hotchk155/MIDI-Switcher/images/001.JPG

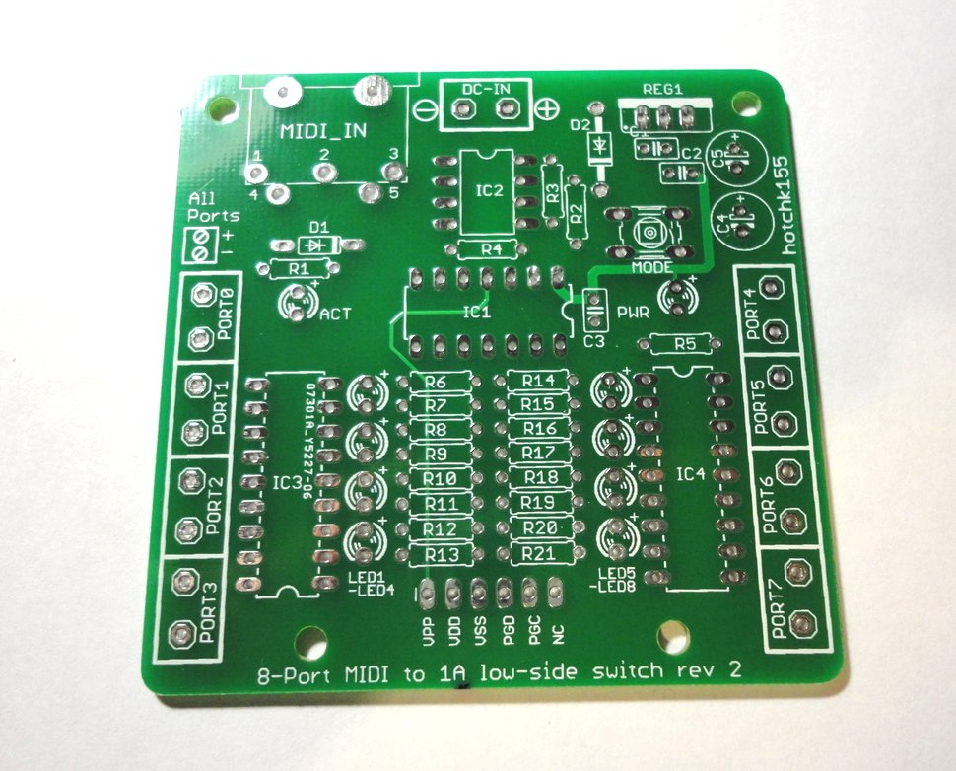
images/001.JPG
