hotchk155/MIDI-Switcher/images/018.JPG

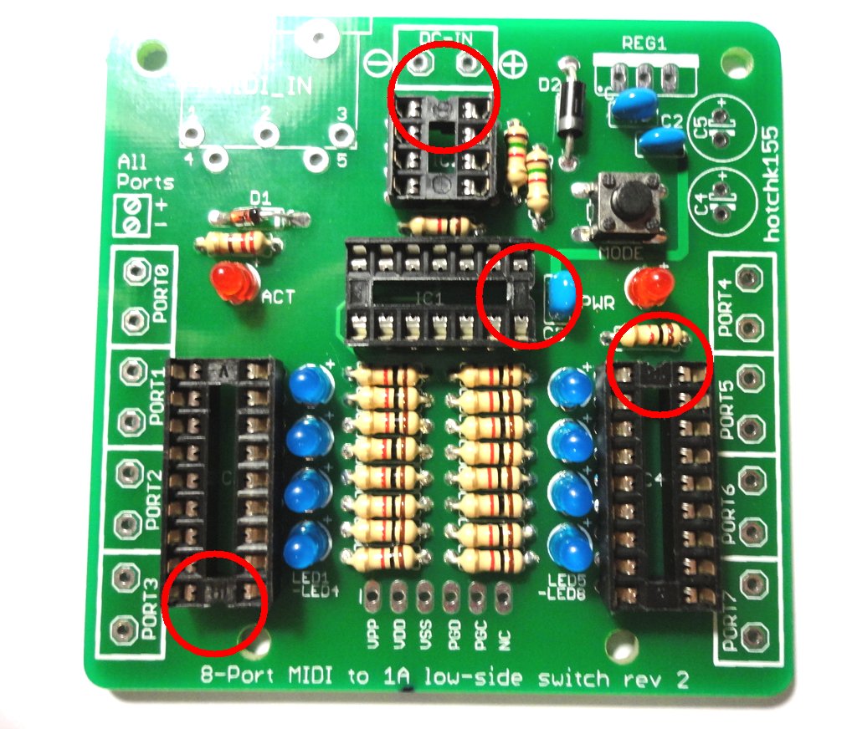
images/018.JPG
