hotchk155/MIDI-Switcher/README.md

The old project. Check MIDI-Switcher-2 for new one
