hotchk155/MIDI-Switcher/images/002.JPG

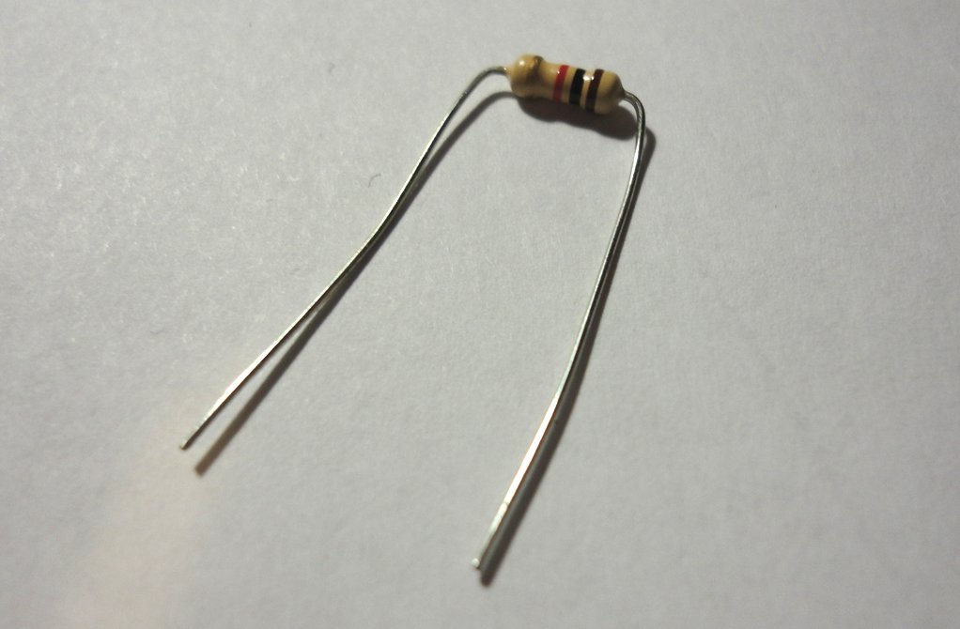
images/002.JPG
