hotchk155/MIDI-Switcher/images/003.JPG

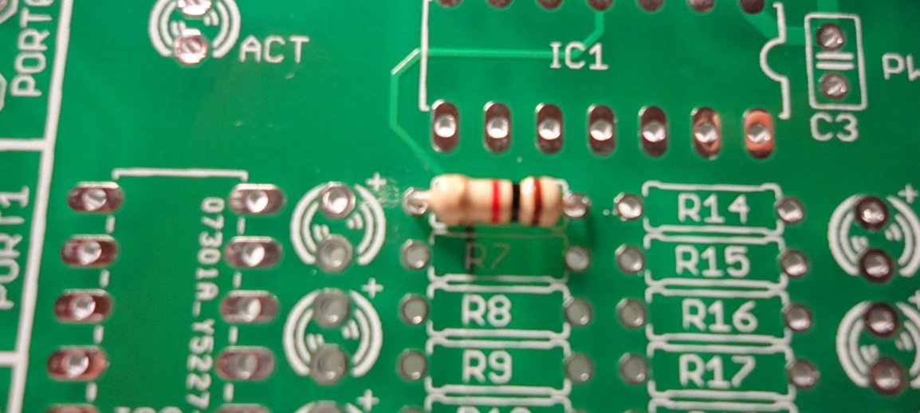
images/003.JPG
