hotchk155/MIDI-Switcher/images/004.JPG

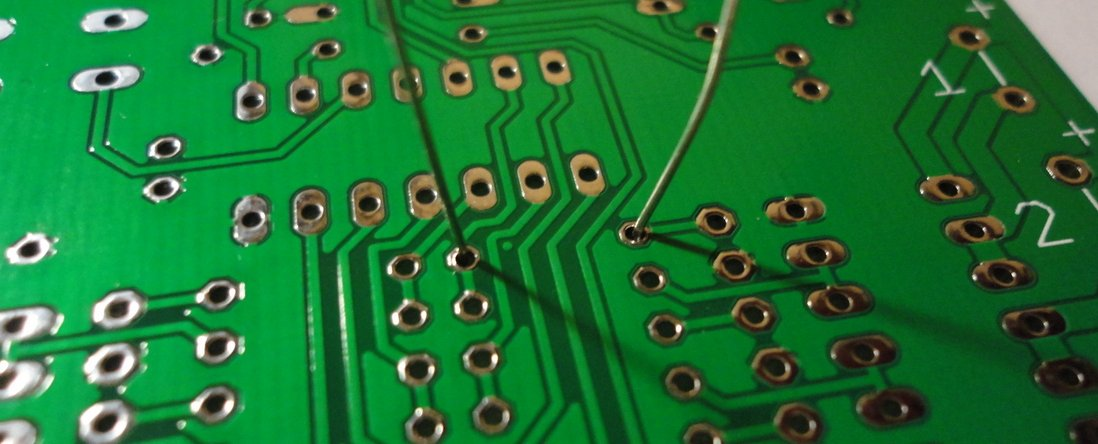
images/004.JPG
