hotchk155/MIDI-Switcher/images/005.JPG

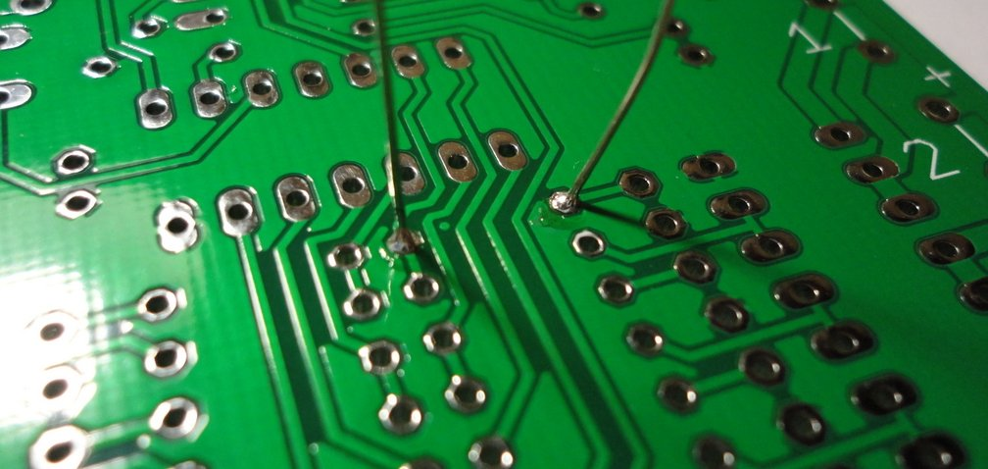
images/005.JPG
