hotchk155/MIDI-Switcher/images/006.JPG

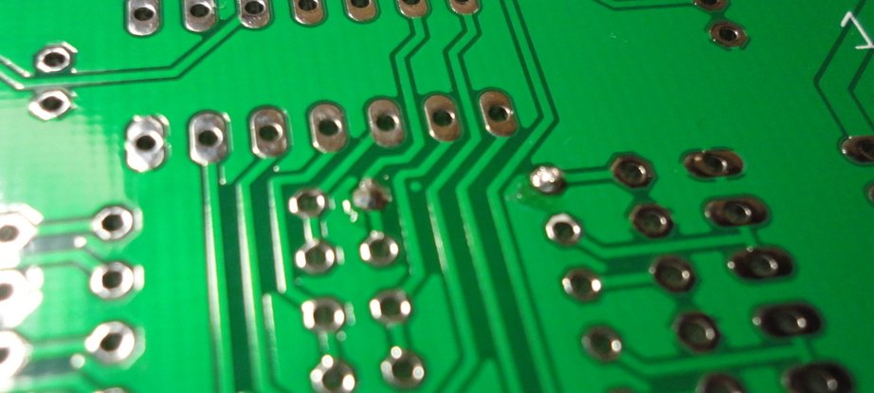
images/006.JPG
