hotchk155/MIDI-Switcher/images/007.JPG

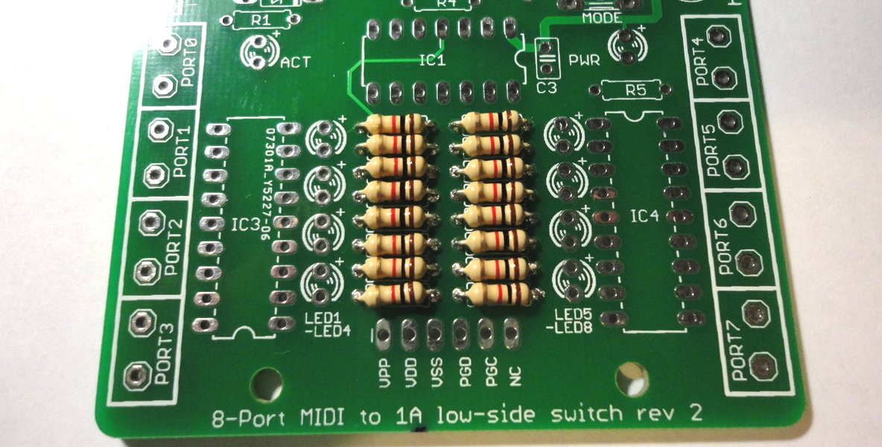
images/007.JPG
