hotchk155/MIDI-Switcher/images/008.JPG

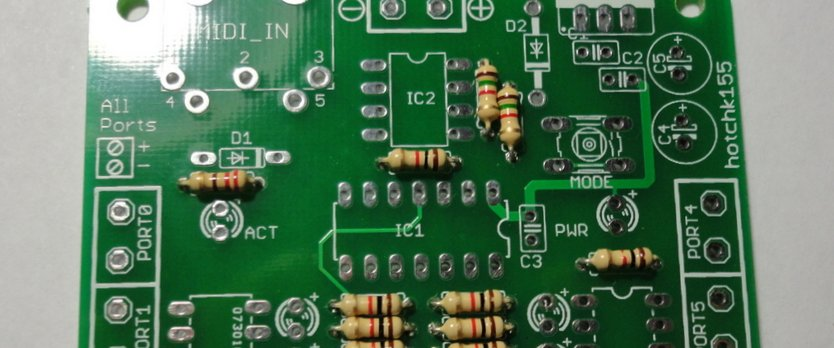
images/008.JPG
