hotchk155/MIDI-Switcher/images/009.JPG

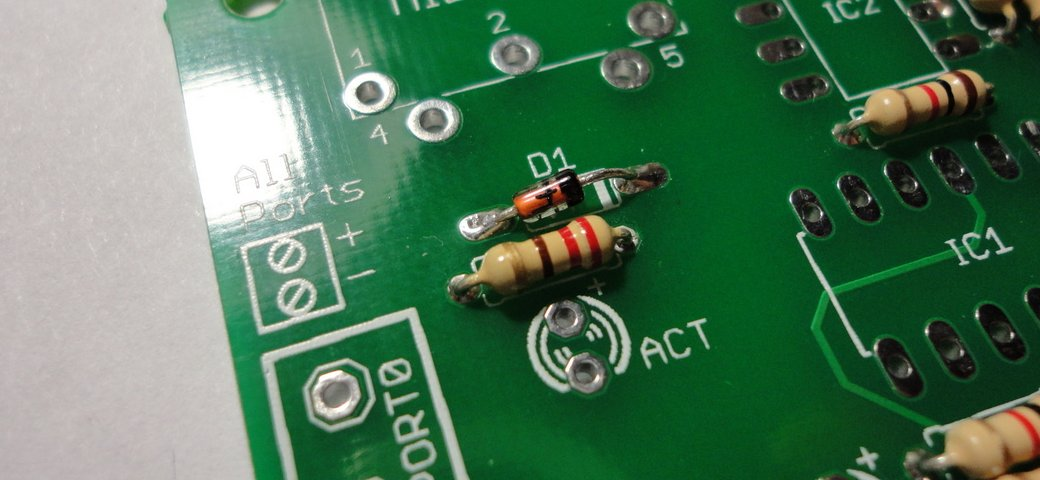
images/009.JPG
