hotchk155/MIDI-Switcher/images/010.JPG

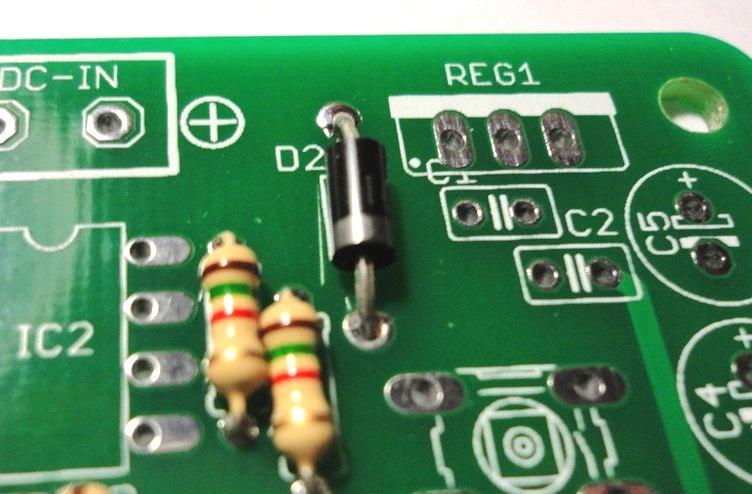
images/010.JPG
