hotchk155/MIDI-Switcher/images/011.JPG

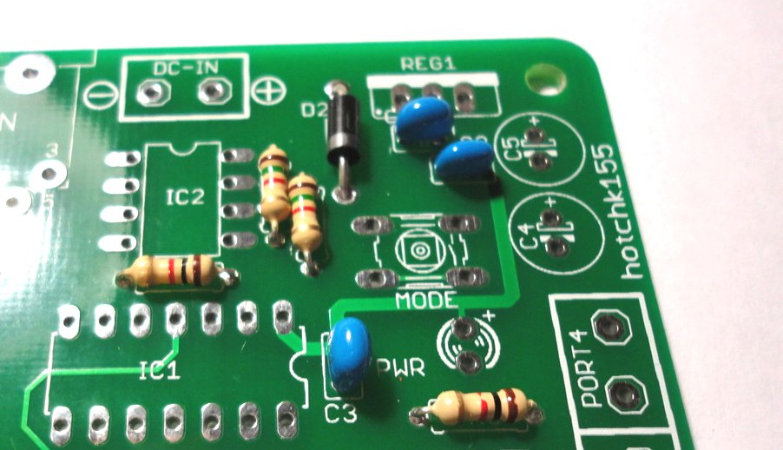
images/011.JPG
