hotchk155/MIDI-Switcher/images/012.JPG

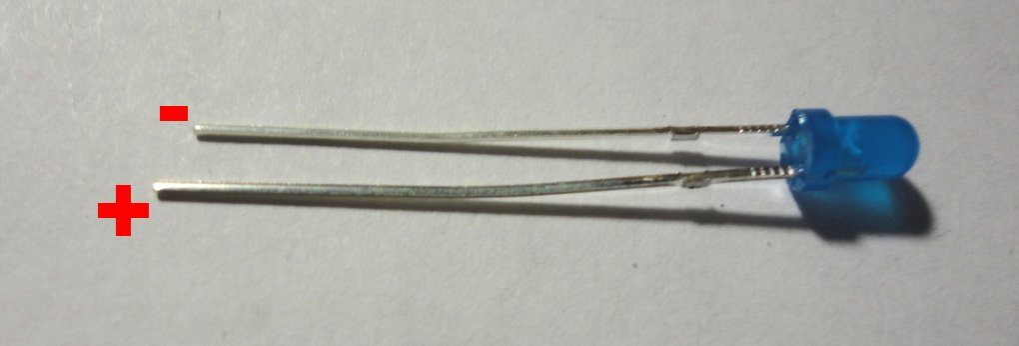
images/012.JPG
