hotchk155/MIDI-Switcher/images/013.JPG

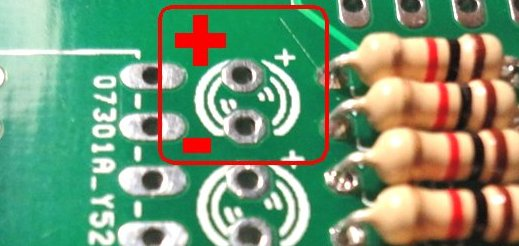
images/013.JPG
