hotchk155/MIDI-Switcher/images/014.JPG

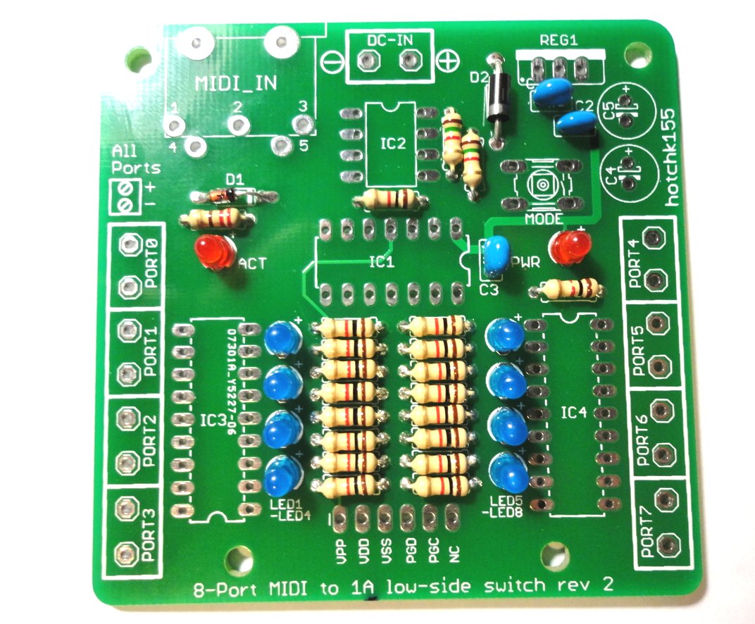
images/014.JPG
