hotchk155/MIDI-Switcher/images/015.JPG

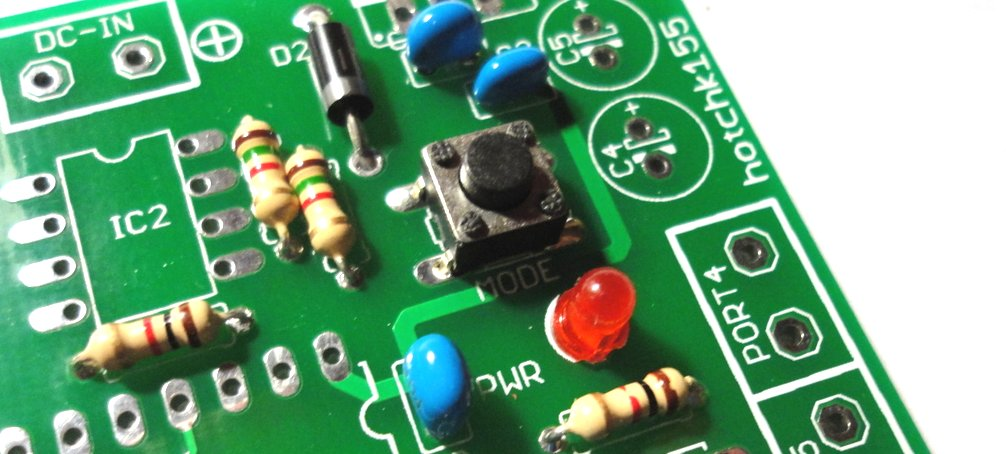
images/015.JPG
