hotchk155/MIDI-Switcher/images/016.JPG

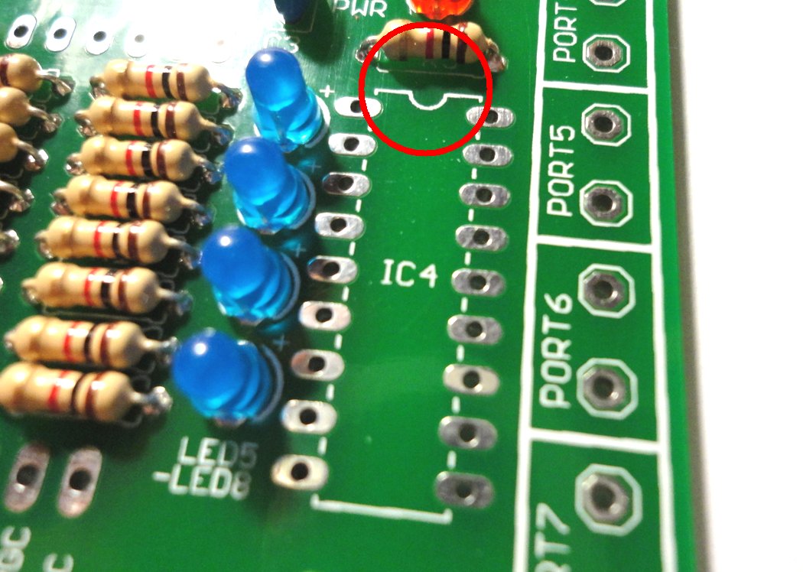
images/016.JPG
