hotchk155/MIDI-Switcher/images/017.JPG

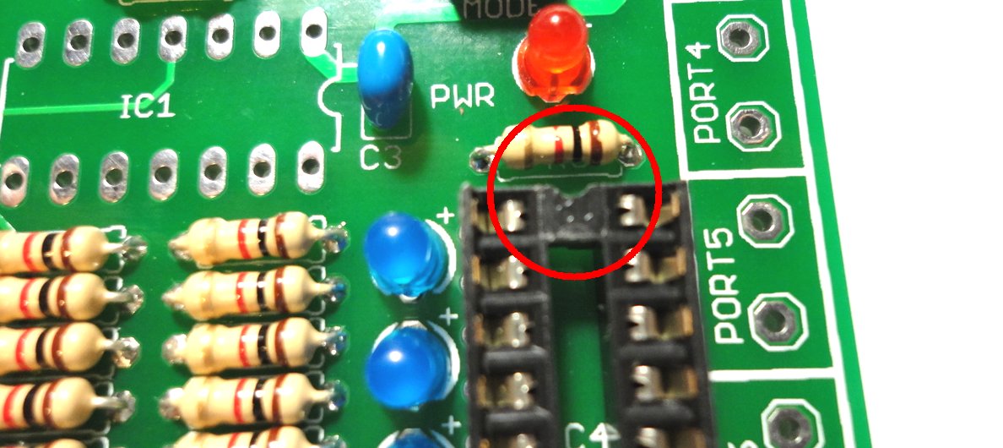
images/017.JPG
