hotchk155/MIDI-Switcher/images/019.JPG

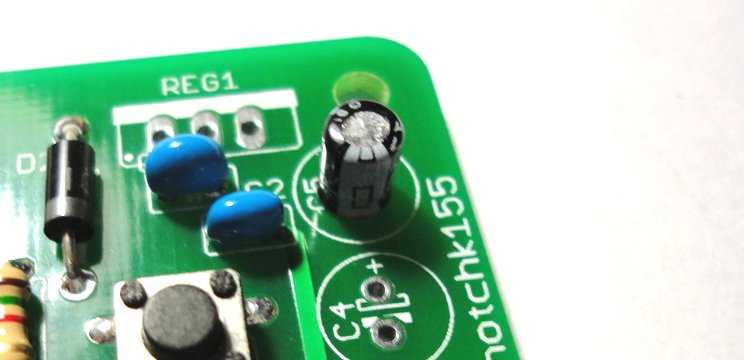
images/019.JPG
