hotchk155/MIDI-Switcher/images/020.JPG

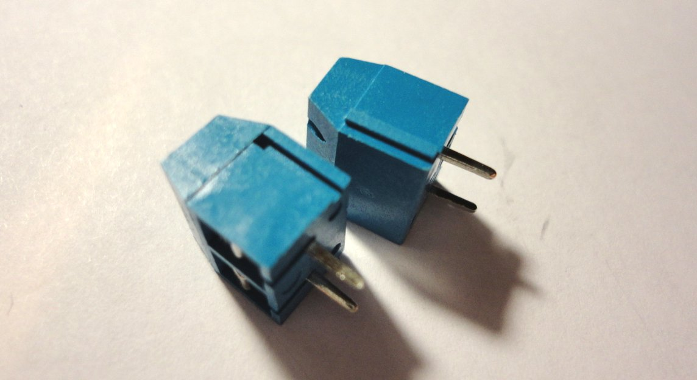
images/020.JPG
