hotchk155/MIDI-Switcher/images/021.JPG

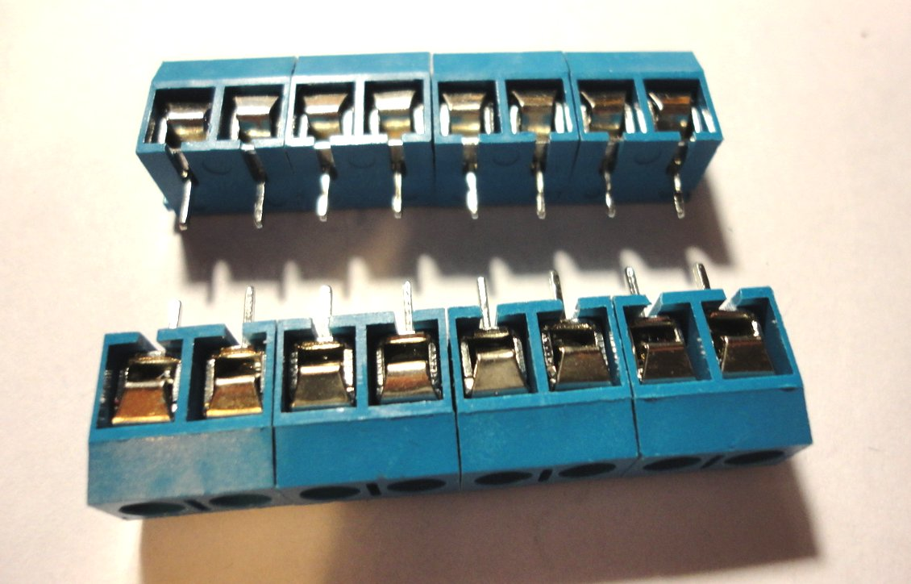
images/021.JPG
