hotchk155/MIDI-Switcher/images/022.JPG

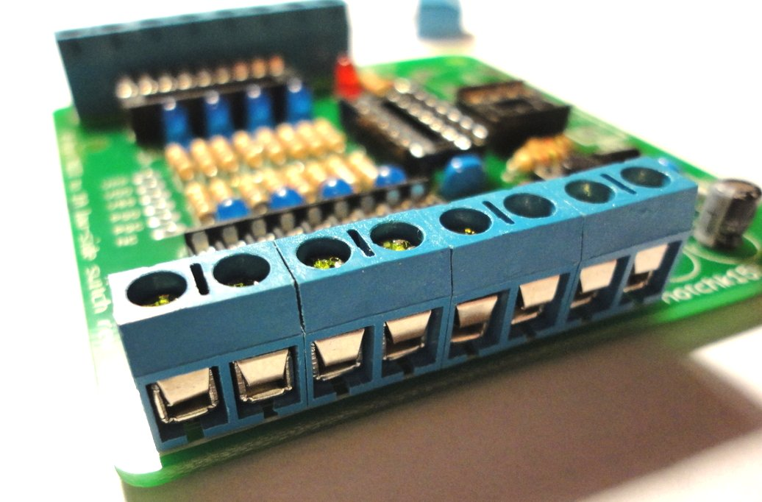
images/022.JPG
