hotchk155/MIDI-Switcher/images/023.JPG

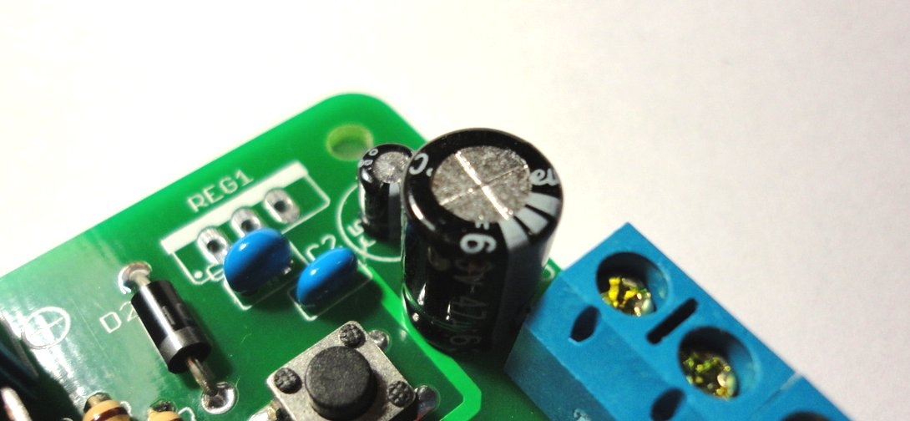
images/023.JPG
