hotchk155/MIDI-Switcher/images/024.JPG

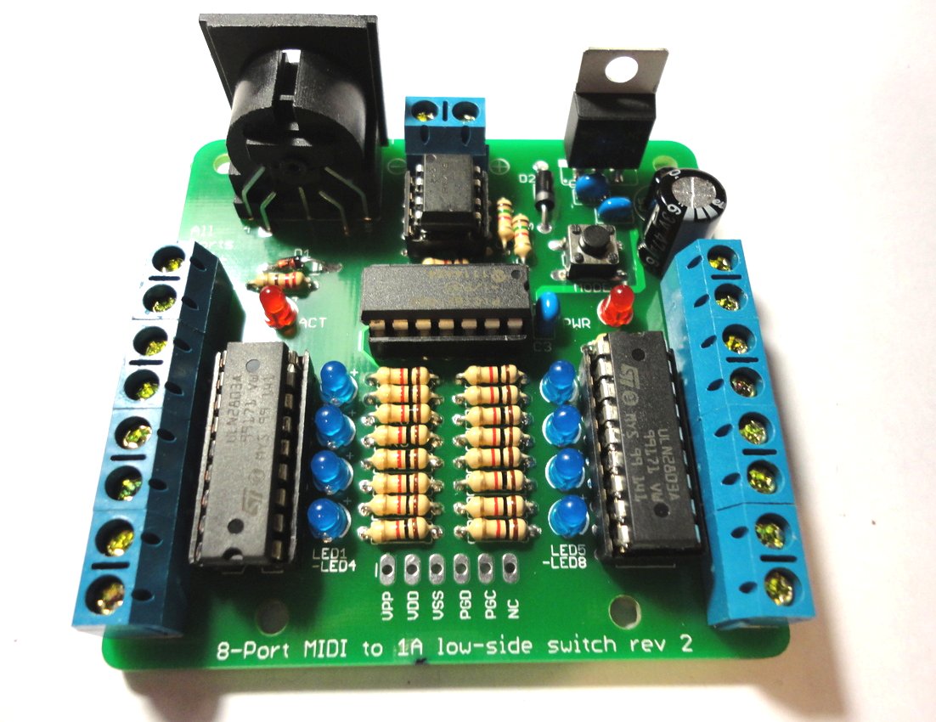
images/024.JPG
