hotchk155/MIDI-Switcher/images/025.JPG

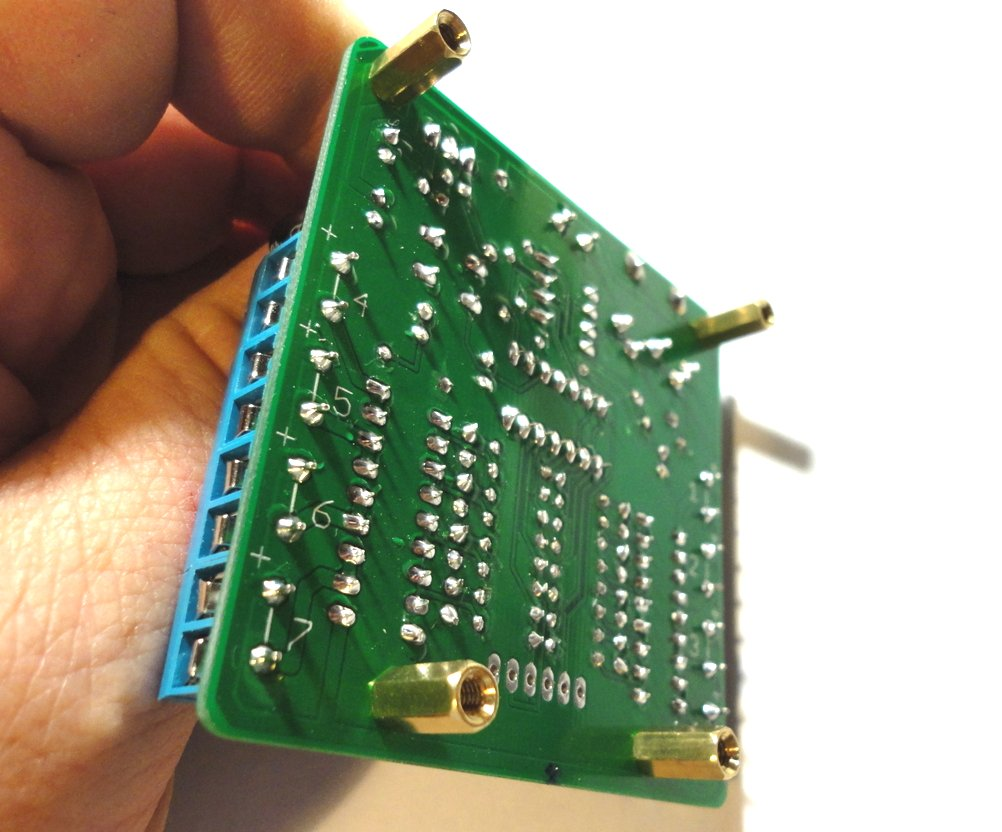
images/025.JPG
