hotchk155/MIDI-Switcher/images/BOARD1.JPG

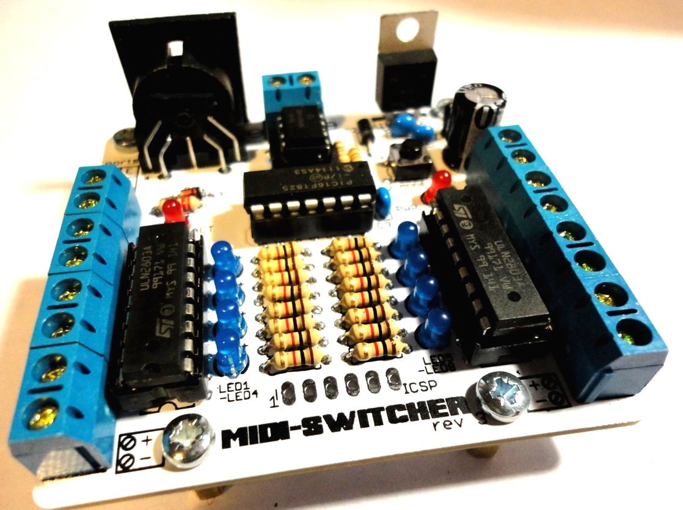
images/BOARD1.JPG
