hotchk155/MIDI-Switcher/images/BOARD2.JPG

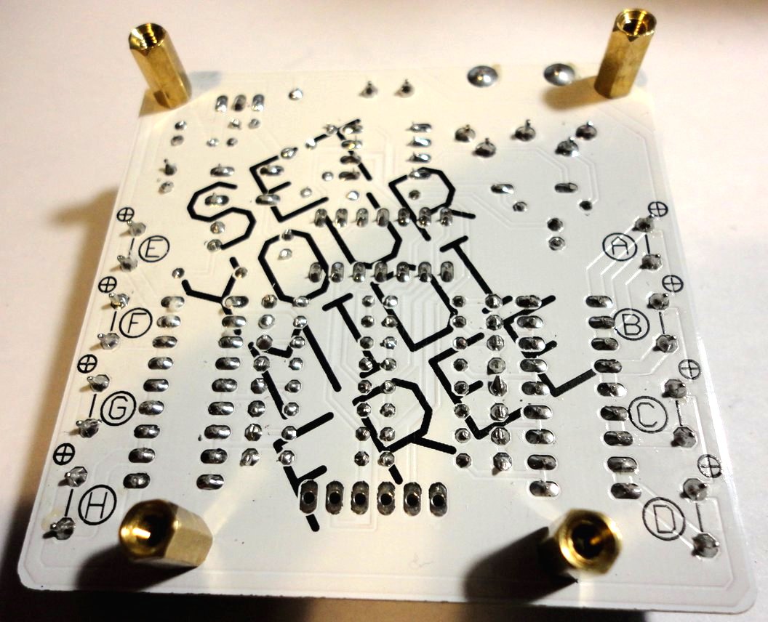
images/BOARD2.JPG
