hotchk155/MIDI-Switcher/images/KIT.JPG

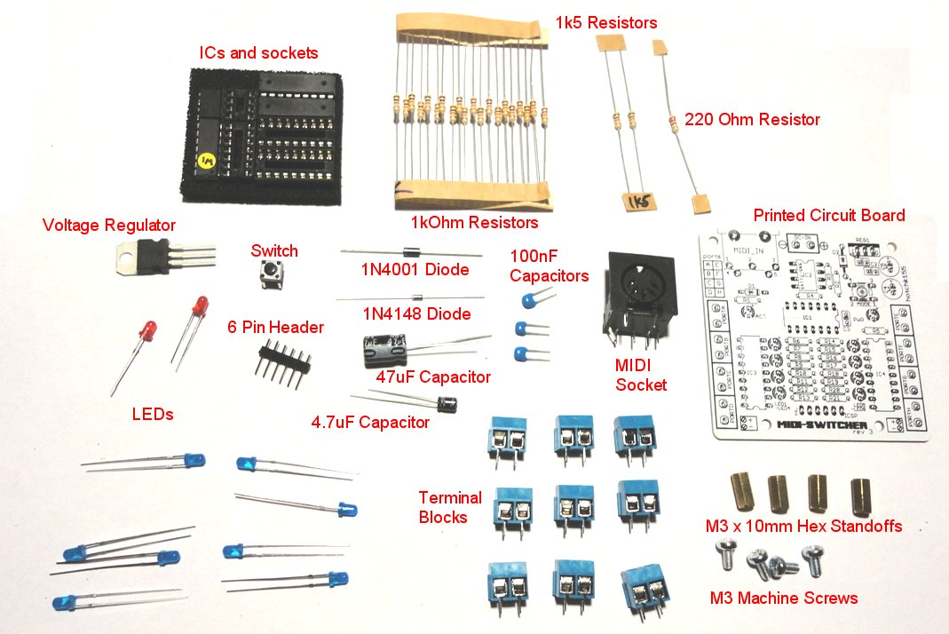
images/KIT.JPG
