hotchk155/MIDI-Switcher/images/msw.png

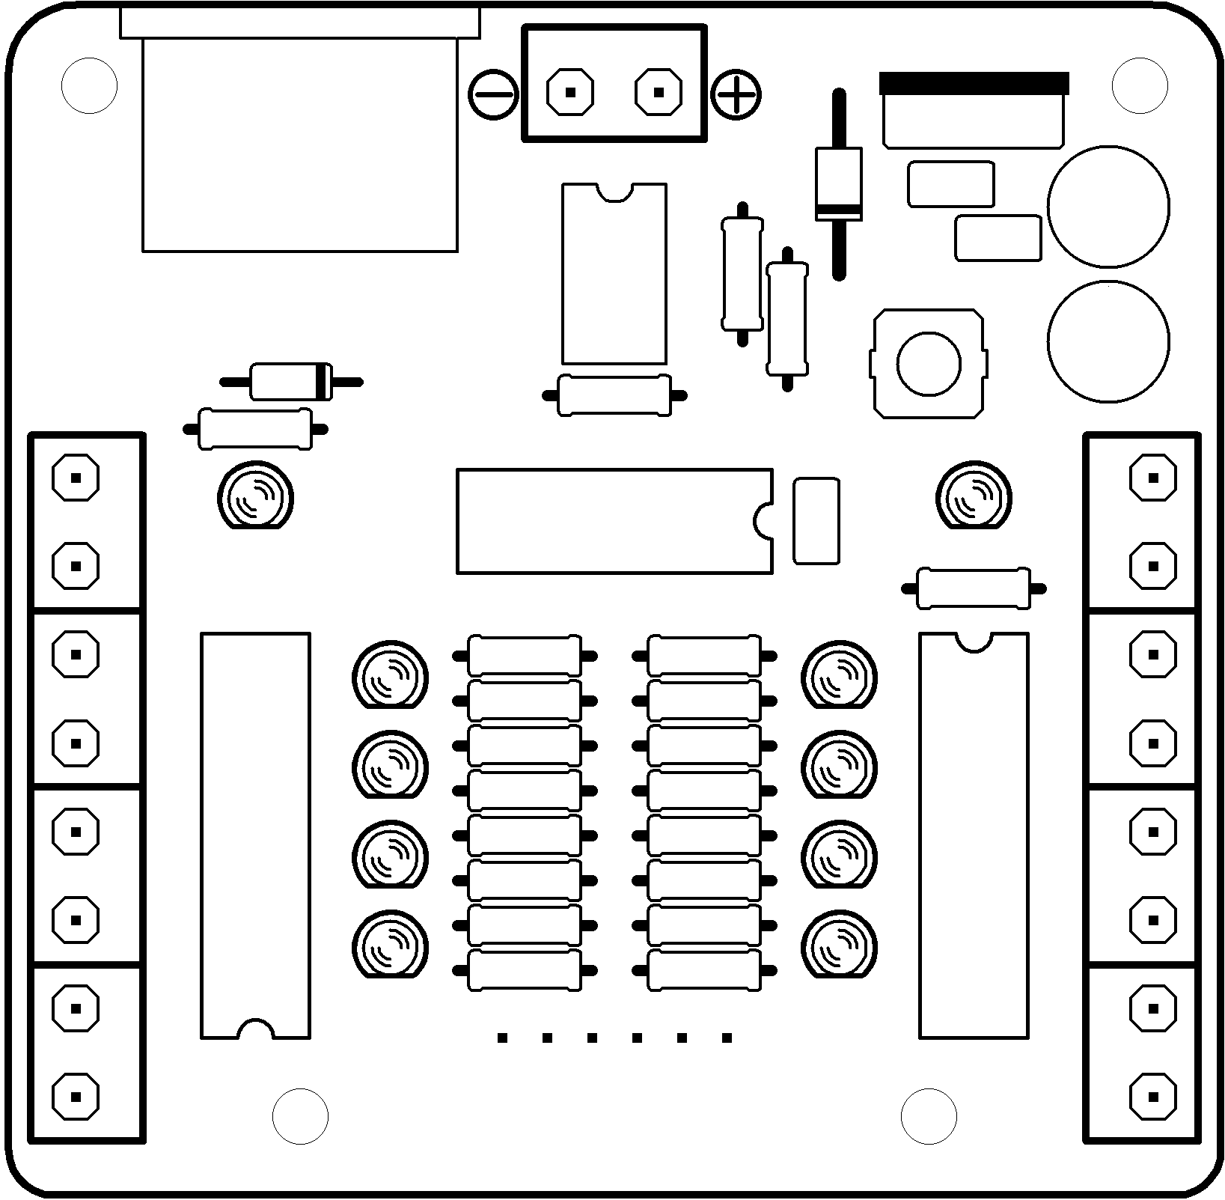
images/msw.png
