hotchk155/MIDI-Switcher/images/pcb.png

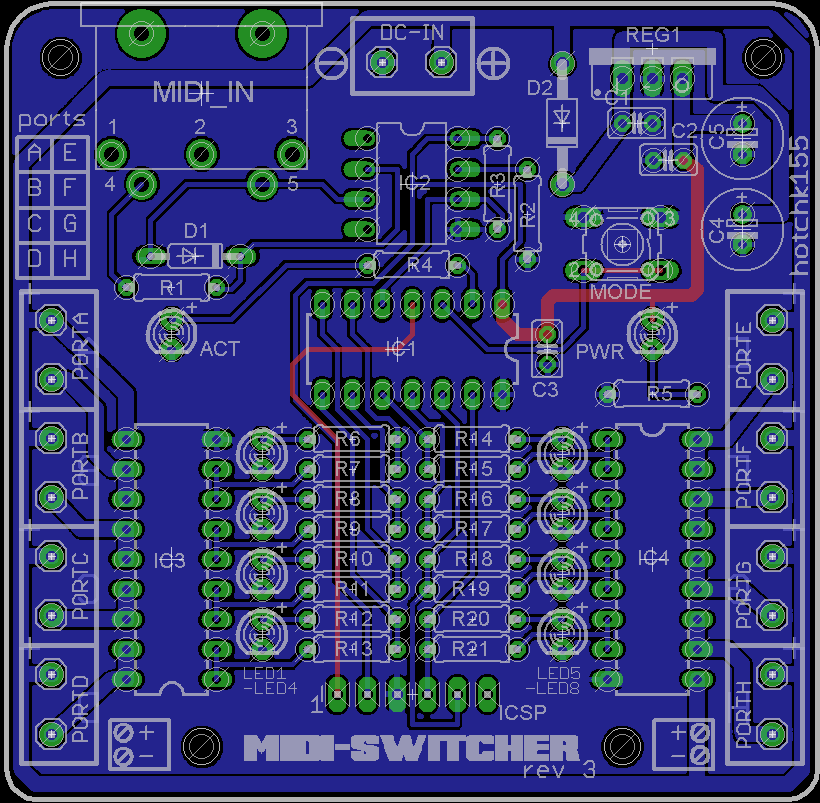
images/pcb.png
