hotchk155/MIDI-Switcher/images/render_bot.png

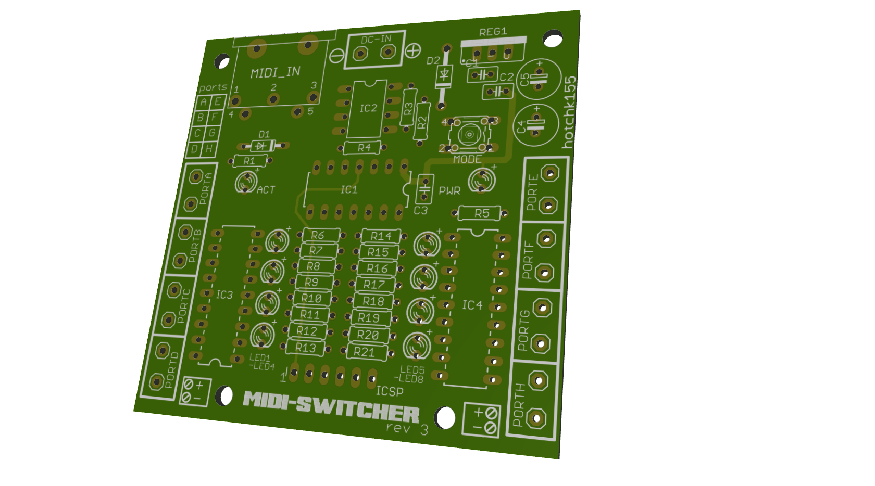
images/render_bot.png
