hotchk155/MIDI-Switcher/images/render_top.png

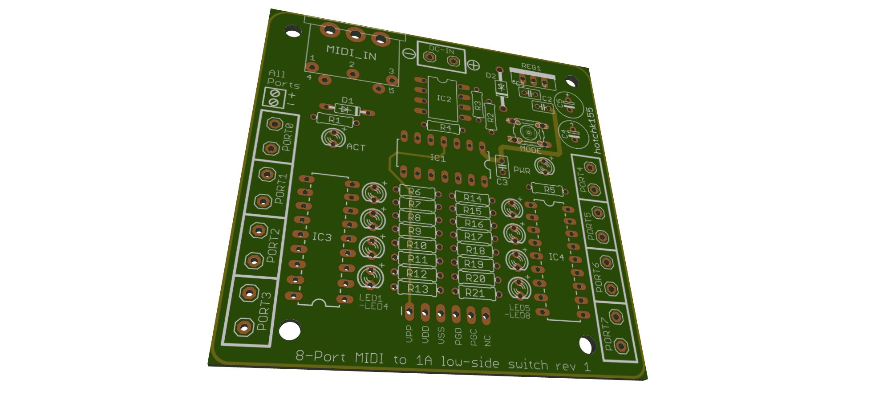
images/render_top.png
