hotchk155/MIDI-Switcher/images/schematic.png

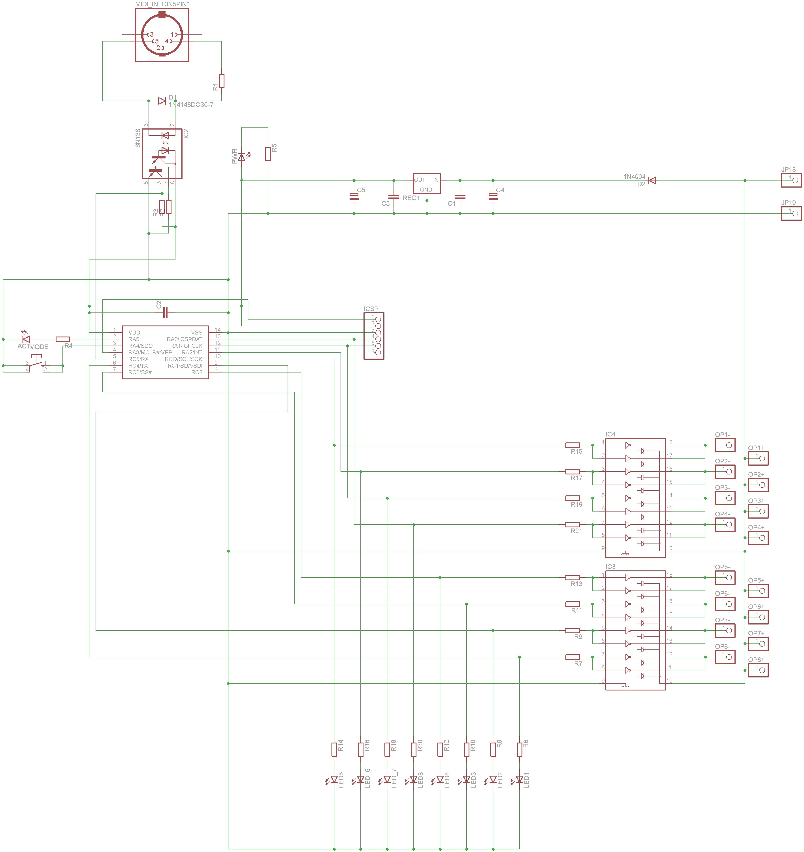
images/schematic.png
