hotchk155/MIDI-Switcher/relay_board/board.png

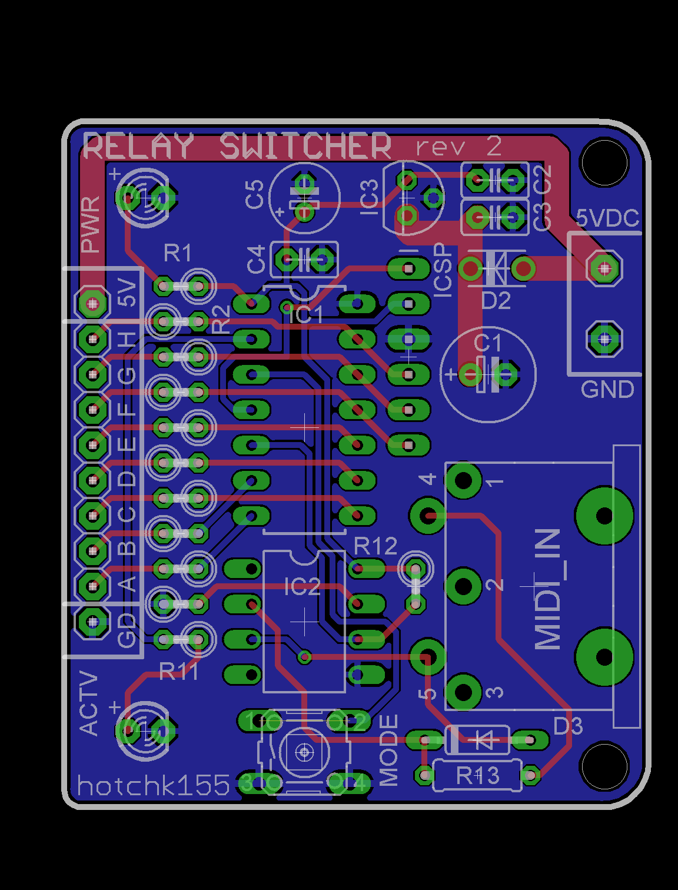
relay_board/board.png
