hotchk155/MIDI-Switcher/relay_board/relay_switcher.png

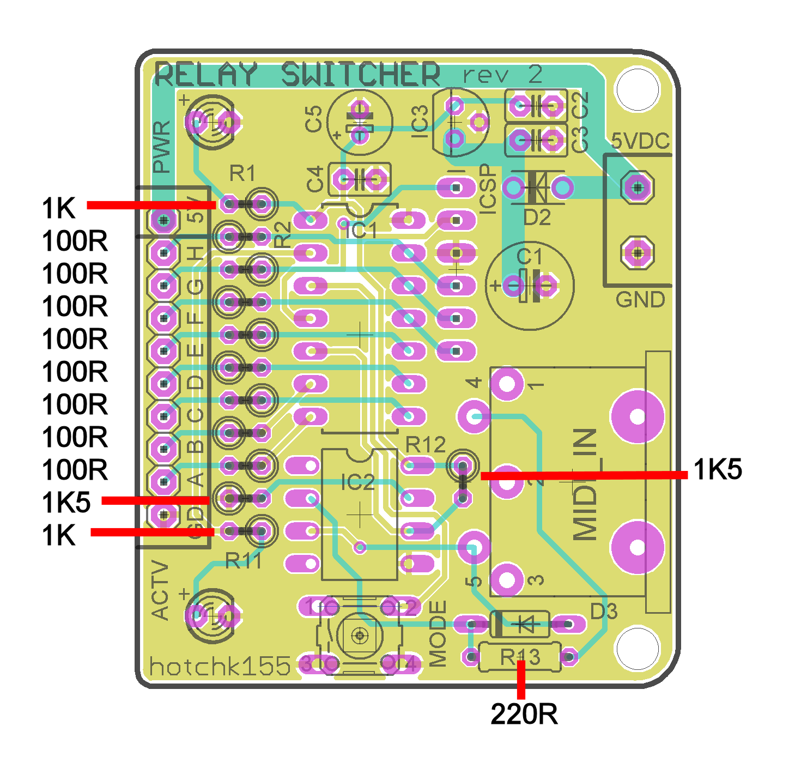
relay_board/relay_switcher.png
