hotchk155/MIDI-Switcher/relay_board/schematic.png

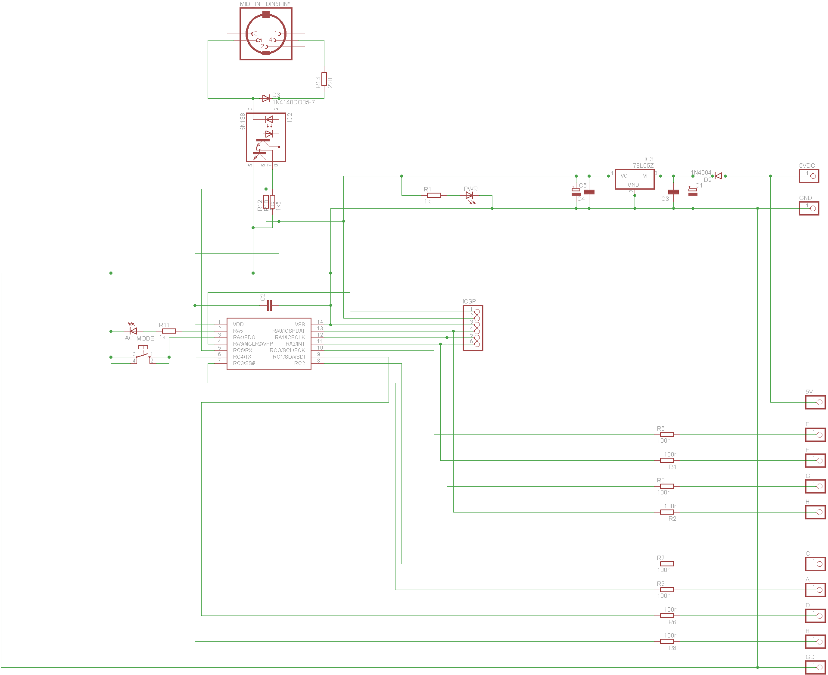
relay_board/schematic.png
