hotchk155/MIDI-Switcher/smt-relay-module/midi-switcher-smt-relay.brd

## EAGLE design smt-relay-module/midi-switcher-smt-relay.brd (2018-01-30)

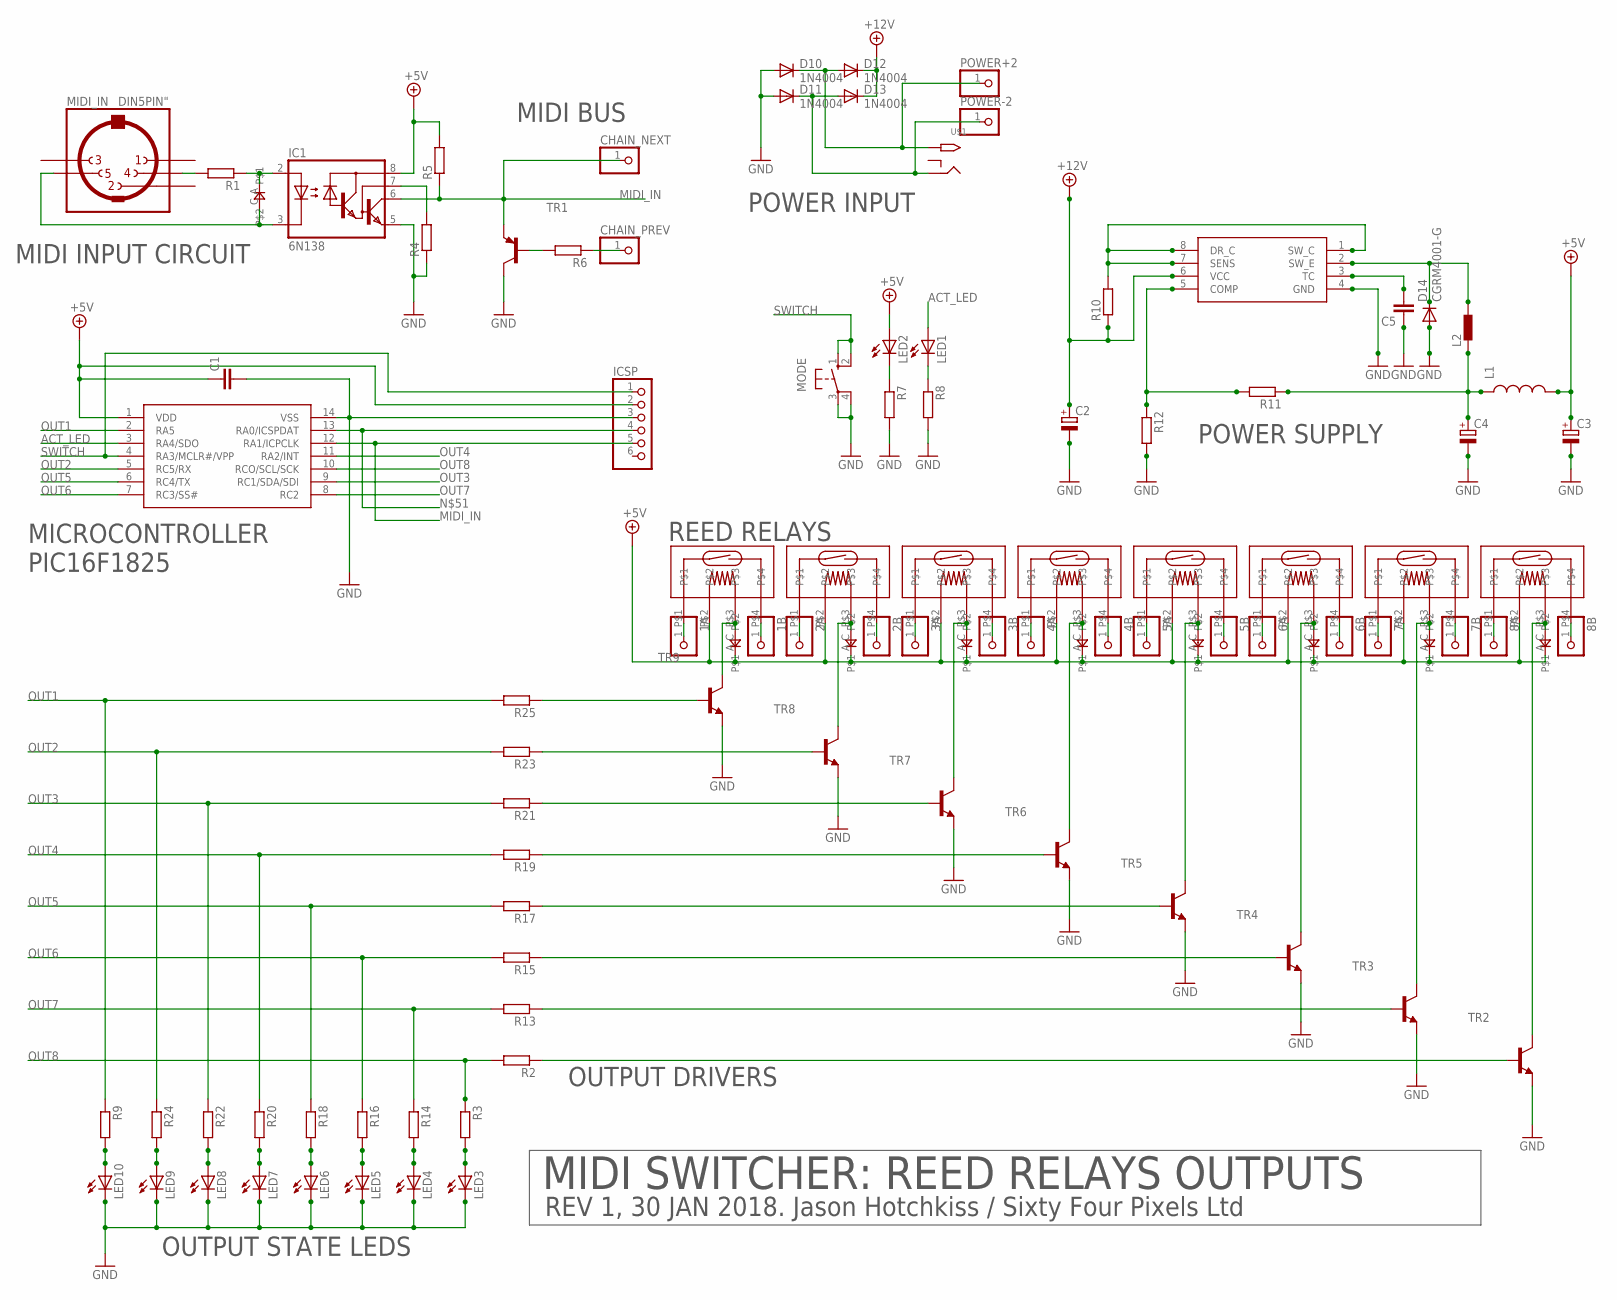
[picture p49: schematic midi-switcher-smt-relay.sch]

Parts:
1A, 1B, 2A, 2B, 3A, 3B, 4A, 4B, 5A, 5B, 6A, 6B, 7A, 7B, 8A, 8B: PINHD-1X1; 1X01
C1, C5: C-EUC0805; C0805
C2, C3, C4: CPOL-EUE2.5-7; E2,5-7
CHAIN_NEXT: PINHD-1X1; 1X01
CHAIN_PREV: PINHD-1X1; 1X01
D1, D2, D3, D4, D5, D6, D7, D8, D9: 0805DIODE
D10, D11, D12, D13: 1N4004; DO-VERT
D14: CGRM4001-G; SOD-123_MINI-SMA
IC1: 6N138; DIL08
IC2: PIC16F1825SO14; SO14
IC3: SP34063A_BOOST_REG; SOIC8
ICSP: HEADER-1X6; 1X06_OVAL
L1: INDUCTOR1210; 1210
L2: DR1030
LED1, LED2, LED3, LED4, LED5, LED6, LED7, LED8, LED9, LED10: LEDCHIP-LED0805; CHIP-LED0805
MIDI_IN: DIN5PIN"; TRUCONN90
MODE: 10-XX; B3F-10XX
POWER+2: PINHD-1X1; 1X01
POWER-2: PINHD-1X1; 1X01
R1, R2, R3, R4, R5, R6, R7, R8, R9, R10, R11, R12, R13, R14, R15, R16, R17, R18, R19, R20, R21, R22, R23, R24, R25: R-EU_R0805; R0805
RL1, RL2, RL3, RL4, RL5, RL6, RL7, RL8: 9007-REED-RELAY
TR1: MMBT3906LT1-PNP-SOT23-BEC; SOT23-BEC
TR2, TR3, TR4, TR5, TR6, TR7, TR8, TR9: MMBT3904LT1-NPN-SOT23-BEC; SOT23-BEC
U$1: 2.1MMJACKTHM; PJ-102A

Connections:
+5V: C1.1, C3.+, D2.A, D3.A, D4.A, D5.A, D6.A, D7.A, D8.A, D9.A, IC1.8 (VCC), IC2.1 (VDD), ICSP.2, L1.2, LED2.A, R5.2, RL1.P$2, RL2.P$2, RL3.P$2, RL4.P$2, RL5.P$2, RL6.P$2, RL7.P$2, RL8.P$2
+12V: C2.+, D12.C, D13.C, IC3.6 (VCC), R10.1
ACT_LED: IC2.3 (RA4/SDO), LED1.A
GND: C1.2, C2.-, C3.-, C4.-, C5.1, D10.A, D11.A, D14.A, IC1.5 (GND), IC2.14 (VSS), IC3.4 (GND), ICSP.3, LED3.C, LED4.C, LED5.C, LED6.C, LED7.C, LED8.C, LED9.C, LED10.C, MODE.3, MODE.4 (P1), R4.1, R7.2, R8.2, R12.2, TR1.C, TR2.E, TR3.E, TR4.E, TR5.E, TR6.E, TR7.E, TR8.E, TR9.E
MIDI_IN: CHAIN_NEXT.1, IC1.6 (VO), IC2.12 (RA1/ICPCLK), ICSP.5, R5.1, TR1.E
unnamed: D1.C, IC1.3 (C), MIDI_IN.5
unnamed: MIDI_IN.4, R1.2
unnamed: D1.A, IC1.2 (A), R1.1
unnamed: IC1.7 (VB), R4.2
unnamed: LED1.C, R8.1
unnamed: LED10.A, R9.2
unnamed: LED9.A, R24.2
unnamed: R25.1, TR9.B
unnamed: R23.1, TR8.B
unnamed: R21.1, TR7.B
unnamed: R19.1, TR6.B
unnamed: R17.1, TR5.B
unnamed: R15.1, TR4.B
unnamed: R13.1, TR3.B
unnamed: R2.1, TR2.B
unnamed: R6.2, TR1.B
unnamed: 1A.1, RL8.P$1
unnamed: CHAIN_PREV.1, R6.1
unnamed: 1B.1, RL8.P$4
unnamed: 2A.1, RL7.P$1
unnamed: 2B.1, RL7.P$4
unnamed: 3A.1, RL6.P$1
unnamed: 3B.1, RL6.P$4
unnamed: LED8.A, R22.2
unnamed: 4A.1, RL5.P$1
unnamed: 4B.1, RL5.P$4
unnamed: 5A.1, RL4.P$1
unnamed: LED2.C, R7.1
unnamed: 5B.1, RL4.P$4
unnamed: 6A.1, RL3.P$1
unnamed: 6B.1, RL3.P$4
unnamed: 7A.1, RL2.P$1
unnamed: LED7.A, R20.2
unnamed: 7B.1, RL2.P$4
unnamed: LED6.A, R18.2
unnamed: LED5.A, R16.2
unnamed: LED4.A, R14.2
unnamed: LED3.A, R3.2
unnamed: D11.C, D13.A, POWER-2.1, U$1.RING
unnamed: 8A.1, RL1.P$1
unnamed: 8B.1, RL1.P$4
unnamed: C5.2, IC3.3 (TC)
unnamed: D10.C, D12.A, POWER+2.1, U$1.TIP
unnamed: D9.C, RL8.P$3, TR9.C
unnamed: D8.C, RL7.P$3, TR8.C
unnamed: D7.C, RL6.P$3, TR7.C
unnamed: D6.C, RL5.P$3, TR6.C
unnamed: D5.C, RL4.P$3, TR5.C
unnamed: D4.C, RL3.P$3, TR4.C
unnamed: D3.C, RL2.P$3, TR3.C
unnamed: IC2.13 (RA0/ICSPDAT), ICSP.4
unnamed: D2.C, RL1.P$3, TR2.C
unnamed: D14.C, IC3.2 (SW_E), L2.2
unnamed: C4.+, L1.1, L2.1, R11.1
unnamed: IC3.5 (COMP), R11.2, R12.1
unnamed: IC3.1 (SW_C), IC3.7 (SENS), IC3.8 (DR_C), R10.2
OUT1: IC2.2 (RA5), R9.1, R25.2
OUT2: IC2.5 (RC5/RX), R23.2, R24.1
OUT3: IC2.9 (RC1/SDA/SDI), R21.2, R22.1
OUT4: IC2.11 (RA2/INT), R19.2, R20.1
OUT5: IC2.6 (RC4/TX), R17.2, R18.1
OUT6: IC2.7 (RC3/SS#), R15.2, R16.1
OUT7: IC2.8 (RC2), R13.2, R14.1
OUT8: IC2.10 (RCO/SCL/SCK), R2.2, R3.1
SWITCH: IC2.4 (RA3/MCLR#/VPP), ICSP.1, MODE.1 (S), MODE.2 (S1)

Notes on the sheet:
MIDI INPUT CIRCUIT
MICROCONTROLLER PIC16F1825
POWER SUPPLY
OUTPUT STATE LEDS
OUTPUT DRIVERS
POWER INPUT
MIDI BUS
REED RELAYS
MIDI SWITCHER: REED RELAYS OUTPUTS
REV 1, 30 JAN 2018. Jason Hotchkiss / Sixty Four Pixels Ltd

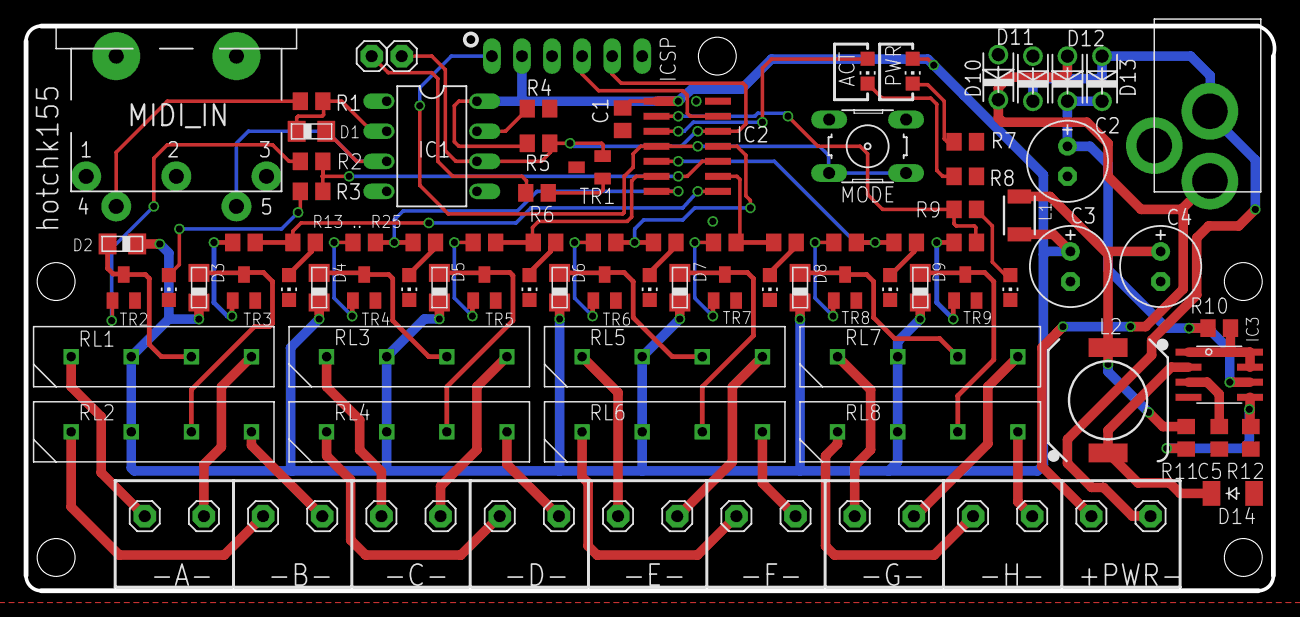
[picture p50: board midi-switcher-smt-relay.brd from above]

Board: 2 copper layers, 105.5 x 47.7 mm, 100 parts (0 on the bottom side), 70 nets.
