hotchk155/MIDI-Switcher/hardware/midi-switcher.brd

## EAGLE design hardware/midi-switcher.brd (2015-08-14)

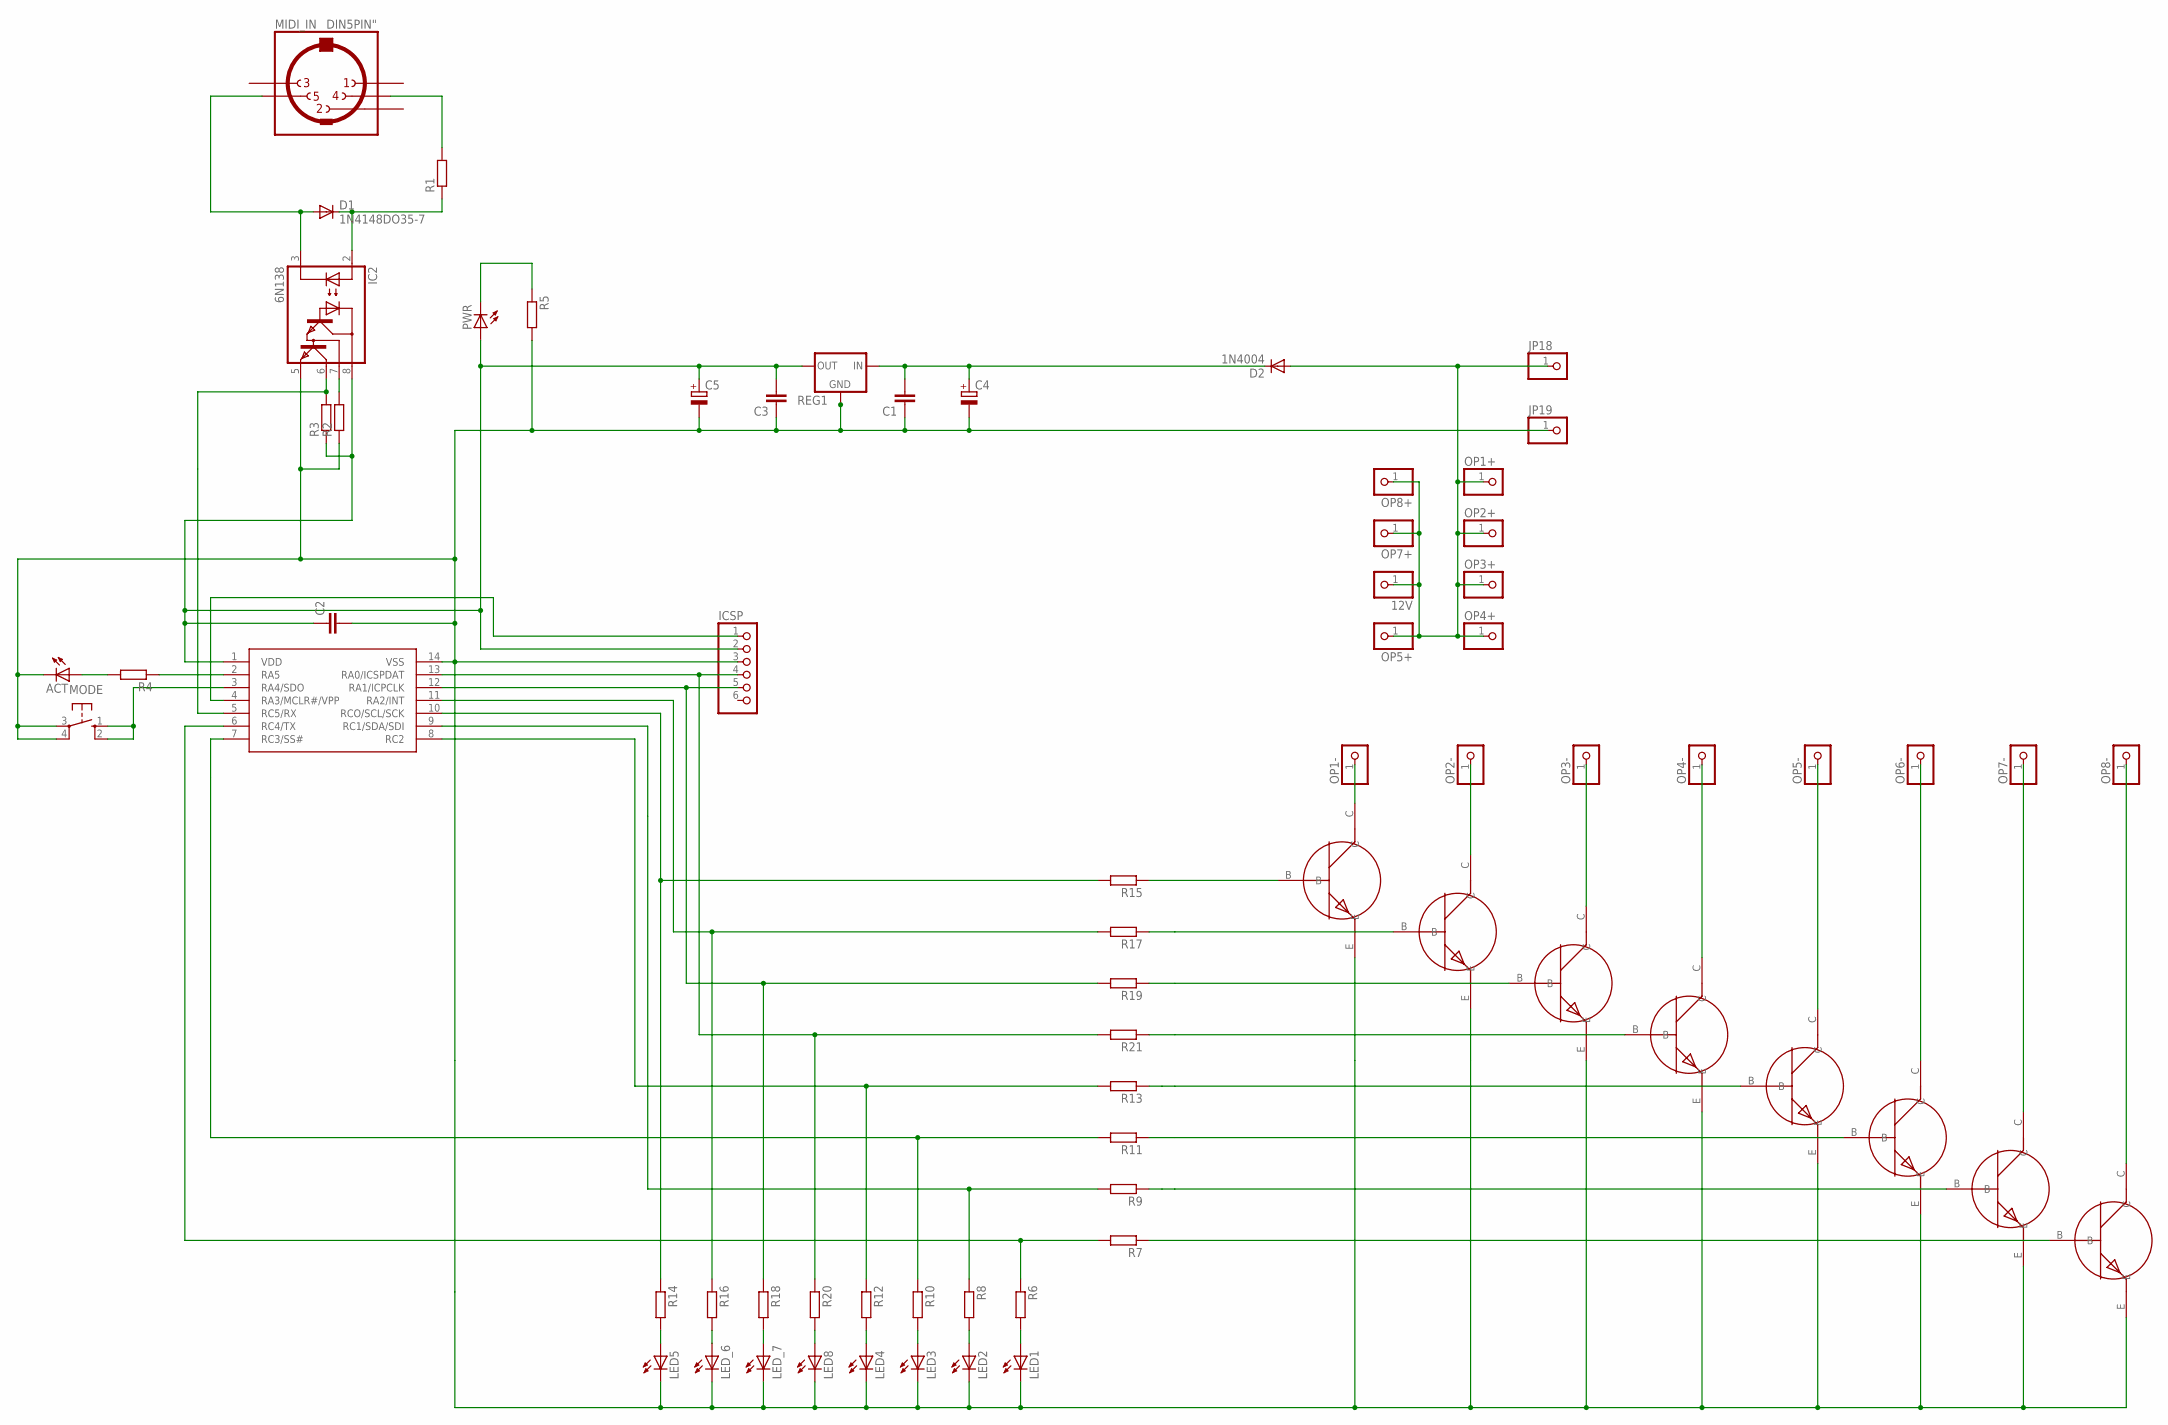
[picture p51: schematic midi-switcher.sch]

Parts:
12V: PINHD-1X1; 1X01
ACT: LED3MM
C1, C2, C3: C-EU025-025X050; C025-025X050
C4, C5: CPOL-EUE2.5-7; E2,5-7
D1: 1N4148DO35-7; DO35-7
D2: 1N4004; DO41-10
IC1: PIC16F1825DIL14; DIL14
IC2: 6N138; DIL08
ICSP: HEADER-1X6; 1X06_OVAL
JP18, JP19: PINHD-1X1; 1X01
LED1, LED2, LED3, LED4, LED5, LED8: LED3MM
LED_6, LED_7: LED3MM
MIDI_IN: DIN5PIN"; TRUCONN90
MODE: 10-XX; B3F-10XX
OP1+, OP1-, OP2+, OP2-, OP3+, OP3-, OP4+, OP4-, OP5+, OP5-, OP6-, OP7+, OP7-, OP8+, OP8-: PINHD-1X1; 1X01
PWR: LED3MM
R1, R2, R3, R4, R5, R6, R7, R8, R9, R10, R11, R12, R13, R14, R15, R16, R17, R18, R19, R20, R21: R-EU_0207/7; 0207/7
REG1: 78XXS
U$1, U$2, U$3, U$4, U$5, U$6, U$7, U$8: TIP120

Connections:
12V: 12V.1, D2.A, JP18.1, OP1+.1, OP2+.1, OP3+.1, OP4+.1, OP5+.1, OP7+.1, OP8+.1
GND: ACT.K (C), C1.1, C2.2, C3.1, C4.-, C5.-, IC1.14 (VSS), IC2.5 (GND), ICSP.3, JP19.1, LED1.K (C), LED2.K (C), LED3.K (C), LED4.K (C), LED5.K (C), LED8.K (C), LED_6.K (C), LED_7.K (C), MODE.3, MODE.4 (P1), R2.1, R5.2, REG1.GND, U$1.E, U$2.E, U$3.E, U$4.E, U$5.E, U$6.E, U$7.E, U$8.E
unnamed: MIDI_IN.4, R1.2
unnamed: D1.C, IC2.2 (A), R1.1
unnamed: D1.A, IC2.3 (C), MIDI_IN.5
unnamed: IC2.7 (VB), R2.2
unnamed: ACT.A, R4.2
unnamed: LED5.A, R14.2
unnamed: LED_6.A, R16.2
unnamed: R15.1, U$1.B
unnamed: R17.1, U$2.B
unnamed: R19.1, U$4.B
unnamed: R21.1, U$3.B
unnamed: R13.1, U$5.B
unnamed: R11.1, U$6.B
unnamed: R9.1, U$7.B
unnamed: R7.1, U$8.B
unnamed: IC1.5 (RC5/RX), IC2.6 (VO), R3.2
unnamed: IC1.2 (RA5), R4.1
unnamed: IC1.12 (RA1/ICPCLK), ICSP.5, R18.1, R19.2
unnamed: IC1.13 (RA0/ICSPDAT), ICSP.4, R20.1, R21.2
unnamed: IC1.8 (RC2), R12.1, R13.2
unnamed: IC1.7 (RC3/SS#), R10.1, R11.2
unnamed: IC1.9 (RC1/SDA/SDI), R8.1, R9.2
unnamed: IC1.6 (RC4/TX), R6.1, R7.2
unnamed: LED_7.A, R18.2
unnamed: OP1-.1, U$1.C
unnamed: OP2-.1, U$2.C
unnamed: OP3-.1, U$4.C
unnamed: OP5-.1, U$5.C
unnamed: OP6-.1, U$6.C
unnamed: OP4-.1, U$3.C
unnamed: LED8.A, R20.2
unnamed: IC1.4 (RA3/MCLR#/VPP), ICSP.1
unnamed: LED4.A, R12.2
unnamed: LED3.A, R10.2
unnamed: LED2.A, R8.2
unnamed: LED1.A, R6.2
unnamed: C1.2, C4.+, D2.C, REG1.IN
unnamed: PWR.K (C), R5.1
unnamed: OP7-.1, U$7.C
unnamed: IC1.3 (RA4/SDO), MODE.1 (S), MODE.2 (S1)
unnamed: IC1.11 (RA2/INT), R16.1, R17.2
unnamed: IC1.10 (RCO/SCL/SCK), R14.1, R15.2
unnamed: OP8-.1, U$8.C
VDD: C2.1, C3.2, C5.+, IC1.1 (VDD), IC2.8 (VCC), ICSP.2, PWR.A, R3.1, REG1.OUT

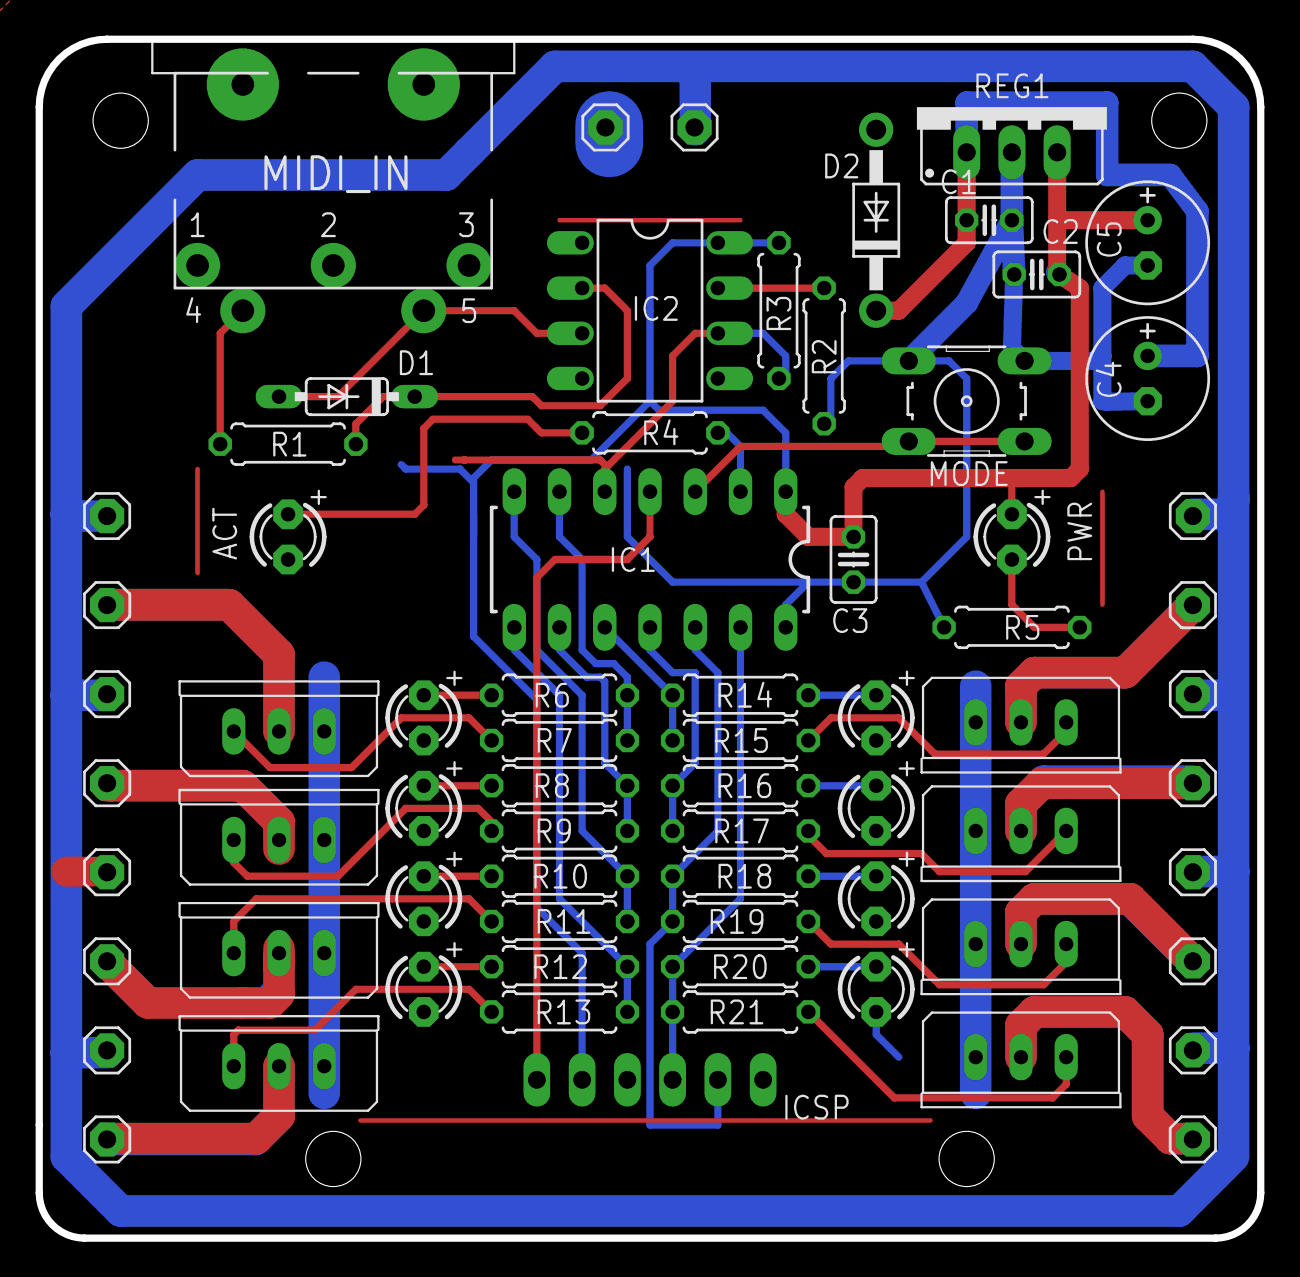
[picture p52: board midi-switcher.brd from above]

Board: 2 copper layers, 68.6 x 67.3 mm, 70 parts (0 on the bottom side), 46 nets.
