hotchk155/MIDI-Switcher/relay_board/relay_board.brd

## EAGLE design relay_board/relay_board.brd (2015-03-20)

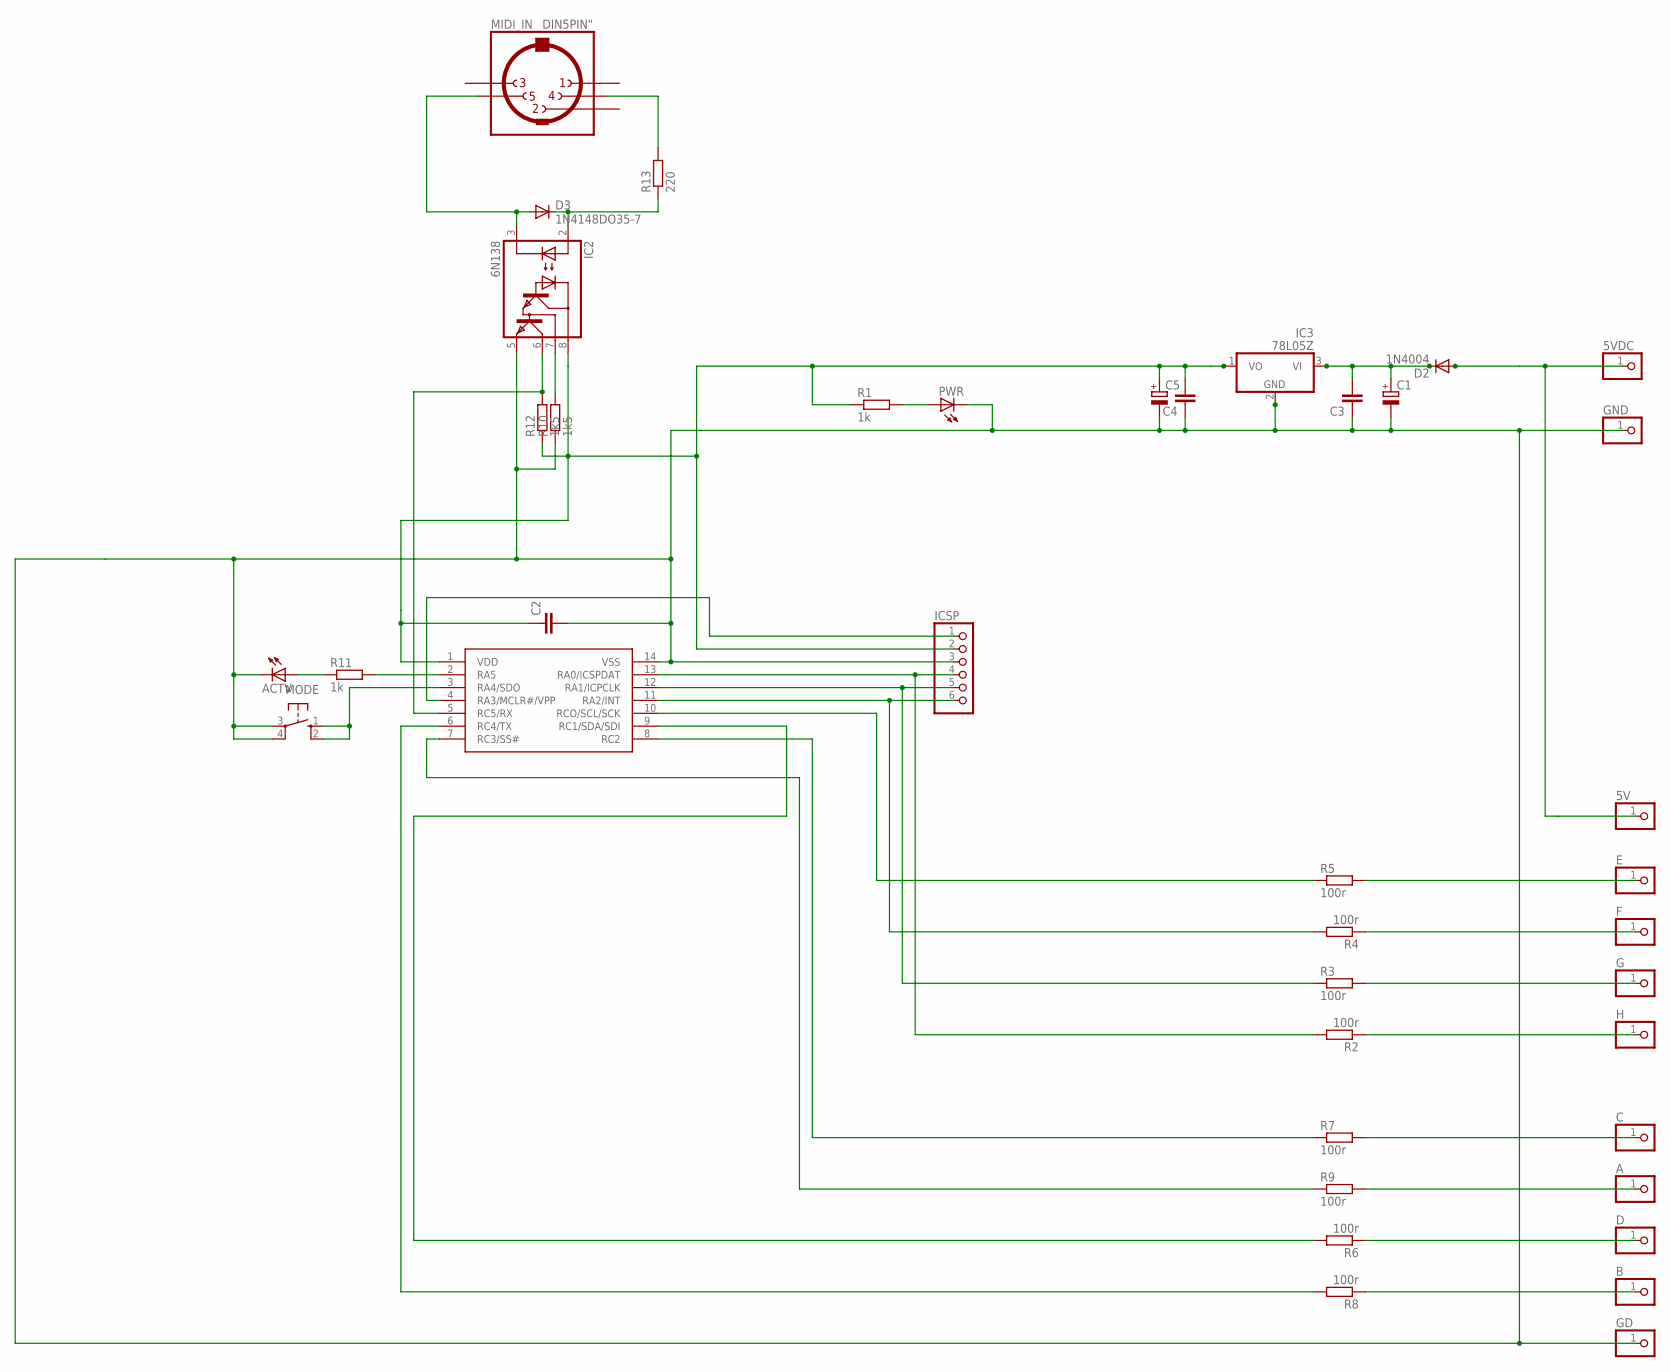
[picture p53: schematic relay_board.sch]

Parts:
5V, 5VDC: PINHD-1X1; 1X01
A: PINHD-1X1; 1X01
ACTV: LED3MM
B: PINHD-1X1; 1X01
C: PINHD-1X1; 1X01
C1: CPOL-EUE2.5-7; E2,5-7
C2, C3, C4: C2.5/2; C2.5-2
C5: CPOL-EUE2-5; E2-5
D: PINHD-1X1; 1X01
D2: 1N4004; DO-VERT
D3: 1N4148DO35-7; DO35-7
E: PINHD-1X1; 1X01
F: PINHD-1X1; 1X01
G: PINHD-1X1; 1X01
GD: PINHD-1X1; 1X01
GND: PINHD-1X1; 1X01
H: PINHD-1X1; 1X01
IC1: PIC16F1825DIL14; DIL14
IC2: 6N138; DIL08
IC3: 78L05Z; TO92
ICSP: HEADER-1X6; 1X06_OVAL
MIDI_IN: DIN5PIN"; TRUCONN90
MODE: 10-XX; B3F-10XX
PWR: LED3MM
R1, R11: 1k; 0207/2V
R2, R3, R4, R5, R6, R7, R8, R9: 100r; 0207/2V
R10, R12: 1k5; 0207/2V
R13: 220; 0207/7

Connections:
3V3: C2.1, C4.2, C5.+, IC1.1 (VDD), IC2.8 (VCC), IC3.1 (VO), ICSP.2, R1.1, R12.1
GND: ACTV.K (C), C1.-, C2.2, C3.1, C4.1, C5.-, GD.1, GND.1, IC1.14 (VSS), IC2.5 (GND), IC3.2 (GND), ICSP.3, MODE.3, MODE.4 (P1), PWR.K (C), R10.1
unnamed: 5V.1, 5VDC.1, D2.A
unnamed: PWR.A, R1.2
unnamed: C1.+, C3.2, D2.C, IC3.3 (VI)
unnamed: MIDI_IN.4, R13.2
unnamed: D3.C, IC2.2 (A), R13.1
unnamed: D3.A, IC2.3 (C), MIDI_IN.5
unnamed: IC2.7 (VB), R10.2
unnamed: F.1, R4.1
unnamed: G.1, R3.2
unnamed: H.1, R2.1
unnamed: C.1, R7.2
unnamed: A.1, R9.2
unnamed: D.1, R6.1
unnamed: B.1, R8.1
unnamed: IC1.12 (RA1/ICPCLK), ICSP.5, R3.1
unnamed: IC1.13 (RA0/ICSPDAT), ICSP.4, R2.2
unnamed: IC1.8 (RC2), R7.1
unnamed: IC1.7 (RC3/SS#), R9.1
unnamed: IC1.9 (RC1/SDA/SDI), R6.2
unnamed: IC1.6 (RC4/TX), R8.2
unnamed: E.1, R5.2
unnamed: IC1.4 (RA3/MCLR#/VPP), ICSP.1
unnamed: IC1.3 (RA4/SDO), MODE.1 (S), MODE.2 (S1)
unnamed: IC1.11 (RA2/INT), ICSP.6, R4.2
unnamed: IC1.10 (RCO/SCL/SCK), R5.1
unnamed: IC1.5 (RC5/RX), IC2.6 (VO), R12.2
unnamed: ACTV.A, R11.1
unnamed: IC1.2 (RA5), R11.2

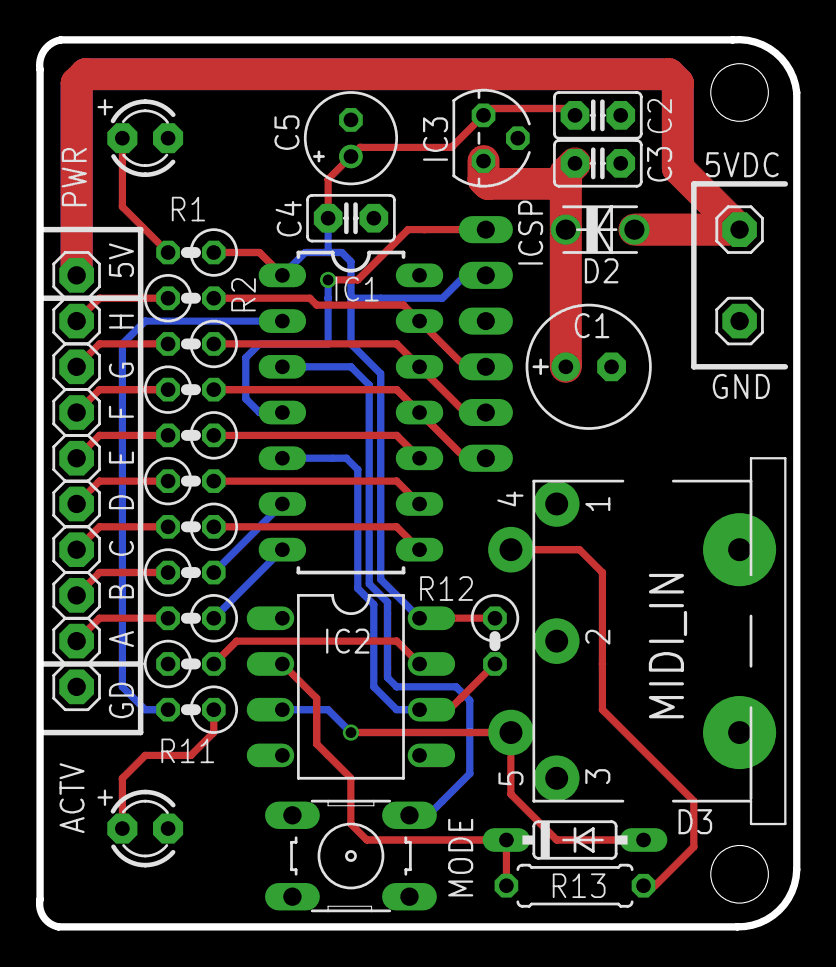
[picture p54: board relay_board.brd from above]

Board: 2 copper layers, 42.1 x 49.3 mm, 40 parts (0 on the bottom side), 30 nets.
