hotchk155/MIDI-Switcher/(commit log)

2013-06-02 revisions to pcb
    [midi-switcher.brd, midi-switcher.sch]
2013-12-01 changes to silkscreen
    [midi-switcher.brd]
2015-01-03 rev4 - tip120
    [midi-switcher.brd, midi-switcher.sch]
2015-01-03 midi thru pins
    [midi-switcher.brd, midi-switcher.sch]
2015-01-06 relay board v1
    [relay_board.brd, relay_board.sch]
2015-01-06 rev 1
    [relay_board.brd]
2015-02-06 relay switcher rev2
    [relay_board.brd, relay_board.sch]
2015-02-06 midi switcher rev5
    [midi-switcher.brd, midi-switcher.sch]
2015-03-20 working on relay board
    [relay_board.brd, relay_board.sch]
2015-03-21 V1.2 First release of Relay Switcher
2015-08-14 fix eagle consistency error
    [midi-switcher.brd, midi-switcher.sch]
2015-08-29 SMT board
    [midi-switcher-smt.brd, midi-switcher-smt.sch]
2015-09-28 version 7
    [midi-switcher-smt.brd, midi-switcher-smt.sch]
2016-07-17 first version draft
    [reed_relay_switcher.brd, reed_relay_switcher.sch]
2016-07-18 REV 1 FINAL
    [reed_relay_switcher.brd, reed_relay_switcher.sch]
2016-11-20 LED PWM
2016-11-25 interrupt approach #2
2016-11-27 using CCP modules to implement 3 fast PWM channels for RGB
2016-12-17 update LED switcher firmware
2016-12-17 led switcher 0.1 release
2017-07-23 new layout
    [midi-switcher-smt.brd, midi-switcher-smt.sch]
2017-07-24 sockets on mm grid
    [midi-switcher-smt.brd]
2018-01-30 REED RELAY MODULE REV1
    [midi-switcher-smt-relay.brd, midi-switcher-smt-relay.sch]
2018-07-10 prep to splt up projects
    [reed_relay_switcher.brd]
2018-07-10 moved smt board
    [midi-switcher-smt.brd, midi-switcher-smt.sch]
2018-10-02 version 1.03 adds support for new SMT switcher
